liangzhi0754/three-fpga-musical-instrument/THIRD_PARTY_NOTICES.md

# 第三方许可说明

## Seeed Studio / PAJ7620 gesture library

`reference/Gesture.cpp` 和 `reference/vendor_paj7620.h` 保留了 Seeed Studio 的 MIT 许可头和版权声明。使用、复制或分发这些文件时应保留原许可和版权文字。

来源：<https://github.com/Seeed-Studio/Gesture_PAJ7620>

## Pololu / ST VL53L0X material

`reference/LICENSE-VL53L0X.txt` 保存了历史测距初始化代码涉及的 Pololu MIT 条款和 STMicroelectronics BSD-3-Clause 条款。当前作品已把测距模块从实际演奏交互中移出，但源码中仍保留历史初始化路径，因此继续保留告知文件。

## Board documentation

Tang Nano 20K 原理图和官方资料属于板卡厂商资料，本仓库只保留链接和自编接线说明，不把厂商 PDF 当作本项目原创内容重新授权。
