liangzhi0754/three-fpga-musical-instrument/program/README.md

# 烧录文件

稳定烧录文件不放在源码目录中，而放在 GitHub **Releases** 的附件中：

- `A_waveform_v25.fs` → A 板
- `B_CELLO_FLUTE_V21.fs` → B 板
- `C_CELLO_FLUTE_OLED_V21.fs` → C 板

三份文件不可互换。Release 同时提供 `Full_Source_Code_v1.0.0.rar` 和 `SHA256SUMS.txt`。
