liangzhi0754/three-fpga-musical-instrument/docs/architecture_1.png

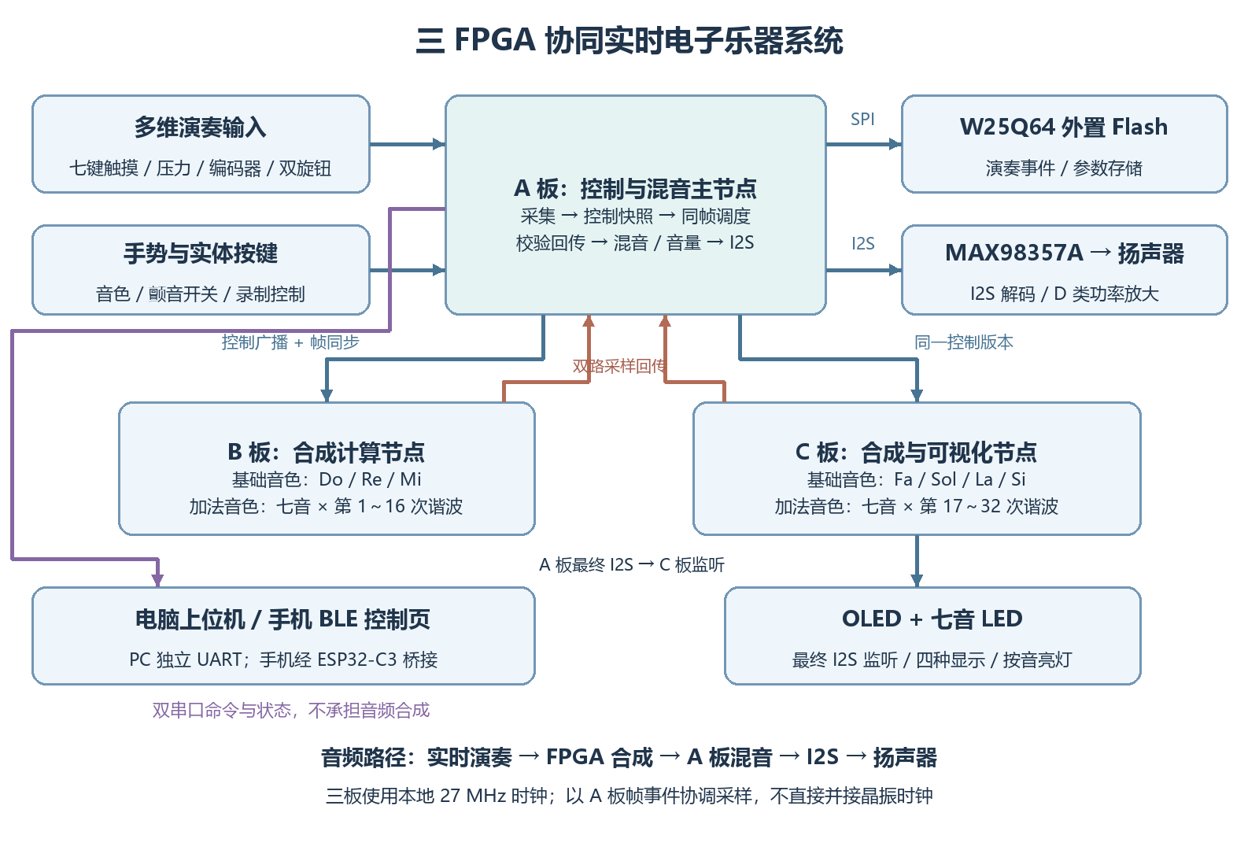
docs/architecture_1.png
