liangzhi0754/three-fpga-musical-instrument/docs/architecture_2.png

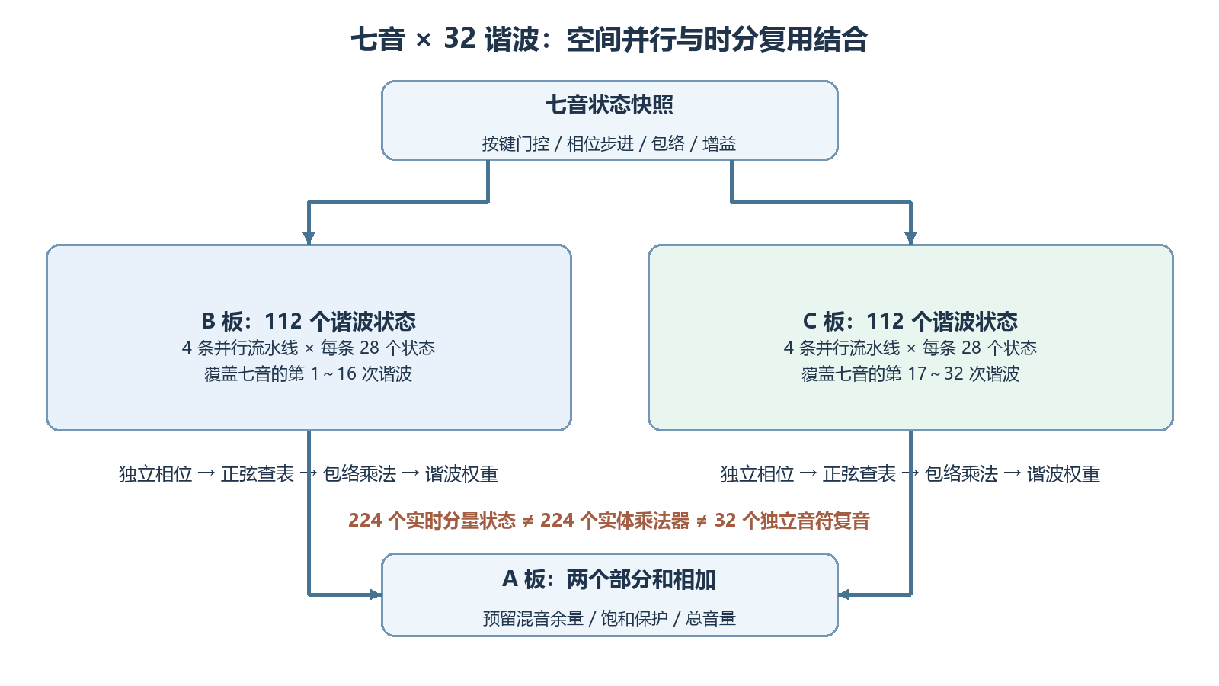
docs/architecture_2.png
