liangzhi0754/three-fpga-musical-instrument/docs/architecture_3.png

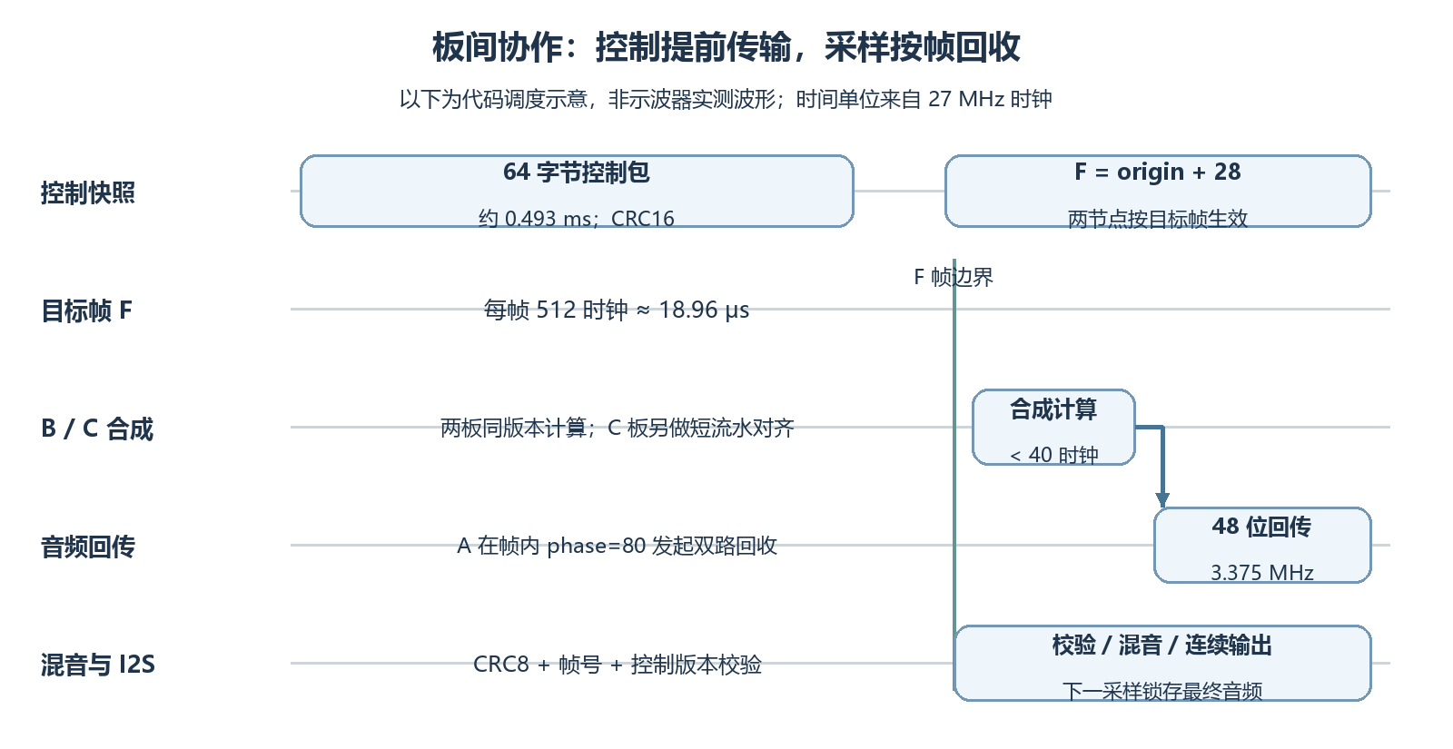
docs/architecture_3.png
