liangzhi0754/three-fpga-musical-instrument/docs/architecture_4.png

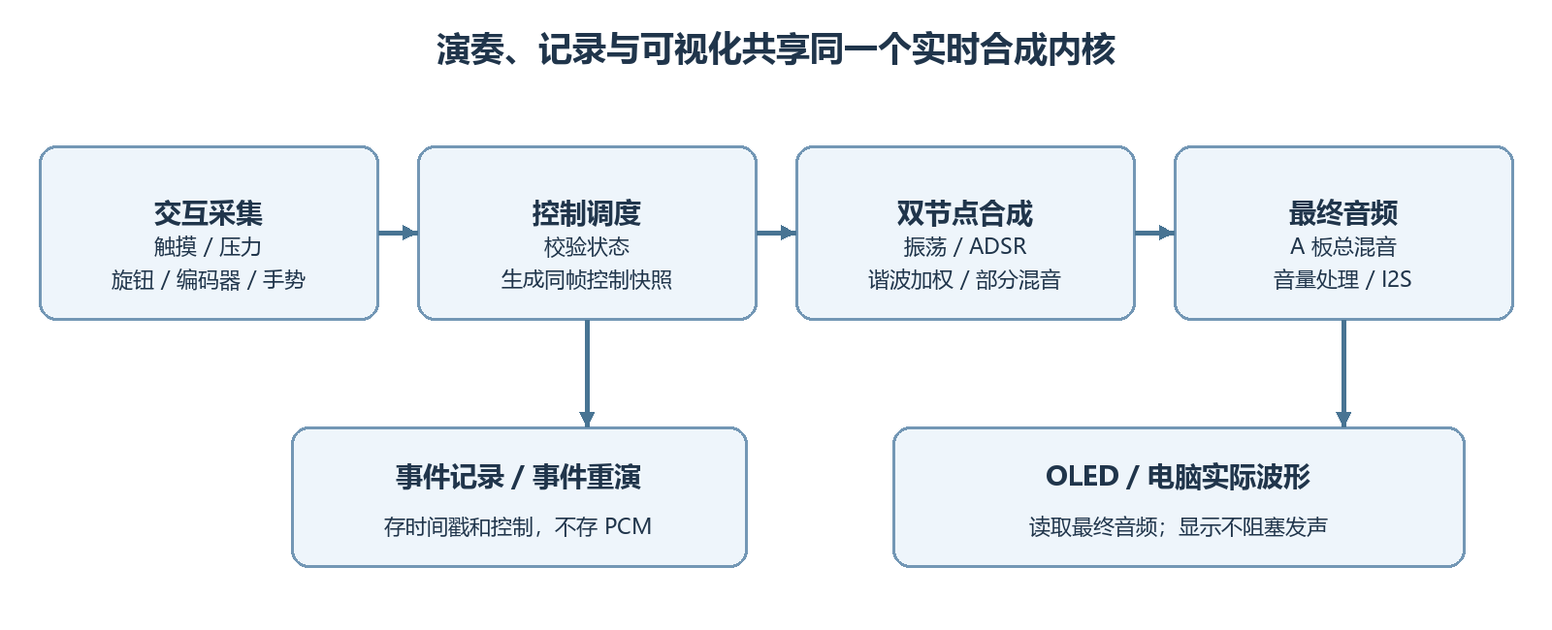
docs/architecture_4.png
