liangzhi0754/three-fpga-musical-instrument/A_WIRING.md

# A板全部接线表（v19）

表中 Axx、Bxx、Cxx 指各板丝印/引脚图对应的 FPGA 管脚编号，不是排针从上往下数的位置。以本工程 projects/A/pins.cst 为软件依据。

## 供电

- 各板与所有模块 GND 必须共地。
- 三块板的 3.3V 稳压输出不能互相并接；A侧传感器从 A板3.3V供电。
- 外接 MAX98357A 使用 LM2596 稳压5V；12V适配器只接LM2596输入。
- 不把外部5V直接并到正在USB供电的开发板5V引脚，除非已经确认电源隔离方式。

## A板信号逐脚核对

| A板管脚 | 信号/用途 | 连接对象 |
|---|---|---|
| A4 | 27MHz板载时钟 | 板内连接，不外接 |
| A15 | 板载状态LED | 板内连接，不外接 |
| A16 | 演奏帧同步输出 | 同时接 B25、C25 |
| A17 | 音频回传时钟输出 | 同时接 B73、C73 |
| A18 | REC录制键，低有效 | 常开按键另一端接公共GND |
| A19 | PLAY重演键，低有效 | 常开按键另一端接公共GND |
| A20 | 音频回传片选输出 | 同时接 B29、C29 |
| A25 | encoder_a编码器输入 | 保持已调通的编码器一相接法，见下文 |
| A27 | ADS总线SCL | 三片ADS1115的SCL并接此处 |
| A28 | ADS总线SDA | 三片ADS1115的SDA并接此处 |
| A29 | 外置Flash时钟 | W25Q64模块 CLK/SCK/SLK |
| A30 | 外置Flash数据输出MOSI | W25Q64模块 DI，芯片DIN/IO0 |
| A31 | 外置Flash片选 | W25Q64模块 CS |
| A41 | C板音频数据输入 | C30 |
| A42 | B板音频数据输入 | B30 |
| A48 | 外置Flash数据输入MISO | W25Q64模块 DO，芯片DOUT/IO1 |
| A49 | 板间控制片选 | 同时接 B26、C26 |
| A51 | 板载音频功放使能 | 软件固定关闭板载功放，不外接 |
| A52 | 电脑串口TX，A→电脑 | USB-TTL RXD |
| A53 | 音色切换键，低有效 | 常开按键另一端接公共GND |
| A54 | 手势总线SCL | PAJ7620U2 SCL |
| A55 | 手势总线SDA | PAJ7620U2 SDA |
| A56 | encoder_b编码器输入 | 保持已调通的编码器另一相接法，见下文 |
| A71 | 触摸总线SCL | MPR121 SCL |
| A72 | 触摸总线SDA | MPR121 SDA |
| A73 | I2S位时钟输出 | MAX98357A BCLK，同时接 C48 |
| A74 | I2S左右时钟输出 | MAX98357A LRC/LRCLK，同时接 C31 |
| A75 | I2S音频数据输出 | MAX98357A DIN，同时接 C41 |
| A76 | 手机/蓝牙串口TX | 暂不使用蓝牙时悬空；使用时接ESP32 GPIO5 |
| A77 | 板间控制时钟 | 同时接 B27、C27 |
| A79 | STOP停止键，低有效 | 常开按键另一端接公共GND |
| A80 | 手机/蓝牙串口RX | 暂不使用蓝牙时悬空；使用时接ESP32 GPIO4 |
| A85 | 板间控制数据 | 同时接 B28、C28 |
| A86 | 电脑串口RX，电脑→A | USB-TTL TXD |

## MPR121和七个铜箔

| 模块脚 | 接哪里 |
|---|---|
| VCC/VIN | 模块确认支持的3.3V供电输入，来自A侧3.3V |
| GND | 公共GND |
| SCL | A71 |
| SDA | A72 |
| ADDR | 公共GND，地址0x5A |
| IRQ | 当前轮询程序不用，悬空 |
| E11、E10、E8、E6、E4、E2、E0 | 分别接Do、Re、Mi、Fa、Sol、La、Si铜箔 |

## 三片ADS1115与电位器/压力片

三片VDD均接A侧3.3V，GND接公共GND，SCL接A27，SDA接A28；ALERT/RDY当前不用。

| ADS用途 | ADDR接法 | 地址 | 模拟输入 |
|---|---|---|---|
| 音高、音量 | GND | 0x48 | A0接音高电位器中间脚；A1接音量电位器中间脚 |
| 压力升降 | VDD（3.3V） | 0x49 | A0接升音压力分压点；A1接降音压力分压点；A2/A3预留 |
| 旧七路压力扩展预留 | SDA（与A28为同一网络） | 0x4A | A0/A1/A2预留；当前两片升降压力不依赖此片 |

每只电位器两侧脚接3.3V和GND，中间滑动脚才接ADS模拟输入。模拟输入不能接5V。

裸FSR两脚没有正负：`3.3V → FSR → 分压点 → 10kΩ电阻 → GND`；分压点接压力ADS的A0或A1。两片FSR各用一只电阻；未使用的模拟输入可接GND避免浮动读数。若现有压力方向已经调通，保持原分压方向。

## PAJ7620U2手势模块

VCC/VIN接模块确认允许的3.3V供电输入，GND接公共GND，SCL接A54，SDA接A55；INT当前不用。测距模块已停用，不需要连接。

## 旋转编码器

当前工程约束始终为encoder_a=A25、encoder_b=A56。你此前说实物按“26和56”已调通：保留那根已成功的实体线，先不要按旧文字重新移动。板上位置与软件编号的差异仍需按实物引脚图确认，不能把软件A25直接改口称A26。A26不是本工程编码器输入。

VCC接3.3V，GND接公共GND，A/B两相接上述两根已成功的信号线；C引脚的含义需按模块原理图确认，不能仅凭字母C当作地或按键。现有固件不用C输入。

## W25Q64特别注意

VCC接3.3V，GND接公共GND。模块若标注D0/D1，需确认其中0是数字还是字母O：**芯片DIN/IO0接A30，DOUT/IO1接A48**。DI/DO命名与IO0/IO1编号容易混淆，不根据“D0”猜方向。裸芯片的WP/HOLD必须被正确拉高；六脚模块一般已处理，按模块原理图核对。

## USB-TTL、功放与按键

- USB-TTL使用3.3V逻辑：RXD接A52，TXD接A86，GND共地，VCC不接。电脑双向控制不使用A76/A80。
- MAX98357A VIN接外部稳压5V，GND共地，BCLK/LRC/DIN按上表；SD_MODE/GAIN保持已经正常发声的接法。
- 扬声器只接功放SPK+和SPK-，这两根都不接公共GND。
- 常开按键按下应使相应信号脚接GND；四脚按键先用通断档识别两组，使用按下才导通的两脚。
- REC短按后松开开始录制；长按约1秒准备录制区。STOP短按停止，长按约1秒保存参数。
- OLED和七个外接LED在C板，不能接到A板同编号脚。
