liangzhi0754/three-fpga-musical-instrument/validation/INHERITED_V22_VALIDATION.md

# v22验证记录

本次仅A板手势过滤HDL变化。A板完整编译通过：Logic12945/20736、CLS8701/10368、BSRAM5/46、DSP4.5/24；27MHz时序Setup/Hold违例0，Fmax45.954MHz。A板最新报告在validation/release_reports/A。

本次 `_v22` 日志：11项HDL回归（新增手势过滤测试、PAJ I2C持续结果及换向、A板上下左右及关闭开关）、35项电脑端、三板音频/I2S/OLED端到端。B/C烧录文件及界面与v21逐字节一致，未对它们重新编译。未实物验证灵敏度或端到端延迟。

以下为继承的v21音色验证记录，表格A行仅代表v21；v22的A资源以上段为准。

编译工具：Gowin V1.9.11.03 Education；器件GW2AR-LV18QN88C8/I7；27MHz。

| 板 | Logic | CLS | BSRAM | DSP | Fmax |
|---|---:|---:|---:|---:|---:|
| A | 12771/20736 | 8710/10368 | 5/46 | 4.5/24 | 52.253MHz |
| B | 6247/20736 | 4424/10368 | 6/46 | 19/24 | 37.568MHz |
| C | 11102/20736 | 7213/10368 | 13/46 | 24/24 | 38.891MHz |

三板完整布局布线通过，Setup/Hold违例均为0。C的DSP用满，竹笛没有新增DSP；气息部分用移位加减与伪随机序列实现。A源码及所有引脚约束与v20一致，A亦重新编译并提供程序。最终报告在validation/release_reports。

本版验证：

- 大提琴与竹笛七音分别渲染后相加，与七键同按对照通过，最大整数舍入差8。每音独立相位/包络，释放音高保留；双板计算40时钟内完成。
- 真实HDL渲染Do/Mi/Sol，幅度范围和音色区别检查通过。频谱检查使用不重叠中心bin，并加入删掉任一正弦成分的负例，作为粗略音频检查；七音叠加对照是多音完整性的主要依据。
- 大提琴和弦输出逐样本与v20相同；前三音色与旧参考逐周期一致。
- 三板控制、CRC回传、音量混音、I2S、OLED端到端测试通过，包含ID4三音和弦。
- OLED、七键LED、压力、编码器、手势、两路串口、第五音色及五态循环回归通过。
- 存储真实SPI模型和慢擦除/STOP/故障恢复模型通过，覆盖音色4的录制重演。
- 电脑端35项测试通过，包含第五音色、和弦显示和存储状态。
- 手机端测试与使用限制见mobile/README.md，JS日志存于mobile/tests。

本次日志名称含 `_v21`；旧版日志不代表本次测试。资源报告为内部编译结果，原有通用时钟路由提示保留。没有测量实物端到端延迟，没有烧录硬件或进行BLE实机测试。

七音复音×每音32谐波，不能直接等同“32个独立音符复音”。竹笛为合成近似，没有真实录音采样或混响新增。旧音色4录音在v21会成为竹笛。手机页面需要手动更新至原网站并刷新，iPhone需支持Web Bluetooth的浏览器；未制作已签名原生iOS安装包，未重编译ESP32固件。
