liangzhi0754/three-fpga-musical-instrument/validation/board_a_tr_cata.html

- Timing Messages
- Timing Summaries
  - STA Tool Run Summary
  - Clock Summary
  - Max Frequency Summary
  - Total Negative Slack Summary
- Timing Details
  - Path Slacks Table
    - Setup Paths Table
    - Hold Paths Table
    - Recovery Paths Table
    - Removal Paths Table
  - Minimum Pulse Width Table
  - Timing Report By Analysis Type
    - Setup Analysis Report
    - Hold Analysis Report
    - Recovery Analysis Report
    - Removal Analysis Report
  - Minimum Pulse Width Report
  - High Fanout Nets Report
  - Route Congestions Report
  - Timing Exceptions Report
    - Setup Analysis Report
    - Hold Analysis Report
    - Recovery Analysis Report
    - Removal Analysis Report
  - Timing Constraints Report
