liangzhi0754/three-fpga-musical-instrument/validation/board_a_tr_content.html

# Timing Messages

Report Title | Timing Analysis Report
Design File | E:\qiansai\three_20k_waveform_v25\projects\A\impl\gwsynthesis\board_a.vg
Physical Constraints File | E:\qiansai\three_20k_waveform_v25\projects\A\pins.cst
Timing Constraint File | E:\qiansai\three_20k_waveform_v25\projects\A\timing.sdc
Tool Version | V1.9.11.03 Education
Part Number | GW2AR-LV18QN88C8/I7
Device | GW2AR-18
Device Version | C
Created Time | Sat Oct 31 16:38:56 2026
Legal Announcement | Copyright (C)2014-2025 Gowin Semiconductor Corporation. All rights reserved.

# Timing Summaries

## STA Tool Run Summary:

Setup Delay Model | Slow 0.95V 85C C8/I7
Hold Delay Model | Fast 1.05V 0C C8/I7
Numbers of Paths Analyzed | 21641
Numbers of Endpoints Analyzed | 20872
Numbers of Falling Endpoints | 0
Numbers of Setup Violated Endpoints | 0
Numbers of Hold Violated Endpoints | 0

## Clock Summary:

NO. | Clock Name | Type | Period | Frequency(MHz) | Rise | Fall | Source | Master | Objects
1 | sys_clk | Base | 37.037 | 27.000 | 0.000 | 18.518 | | | clk

## Max Frequency Summary:

NO. | Clock Name | Constraint | Actual Fmax | Logic Level | Entity
1 | sys_clk | 27.000(MHz) | 44.758(MHz) | 27 | TOP

## Total Negative Slack Summary:

Clock Name | Analysis Type | Endpoints TNS | Number of Endpoints
sys_clk | Setup | 0.000 | 0
sys_clk | Hold | 0.000 | 0

# Timing Details

## Path Slacks Table:

### Setup Paths Table

#### Report Command:report_timing -setup -max_paths 25 -max_common_paths 1

Path Number | Path Slack | From Node | To Node | From Clock | To Clock | Relation | Clock Skew | Data Delay
1 | 14.695 | control/event_packet_244_s0/Q | store/write_shift_489_s3/D | sys_clk:[R] | sys_clk:[R] | 37.037 | 0.000 | 22.307
2 | 14.873 | control/event_packet_244_s0/Q | store/enqueue_busy_s0/D | sys_clk:[R] | sys_clk:[R] | 37.037 | 0.000 | 22.129
3 | 14.972 | control/event_packet_244_s0/Q | store/write_shift_427_s3/D | sys_clk:[R] | sys_clk:[R] | 37.037 | 0.000 | 22.030
4 | 14.972 | control/event_packet_244_s0/Q | store/write_shift_491_s3/D | sys_clk:[R] | sys_clk:[R] | 37.037 | 0.000 | 22.030
5 | 15.192 | control/event_packet_244_s0/Q | store/write_shift_490_s3/D | sys_clk:[R] | sys_clk:[R] | 37.037 | 0.000 | 21.810
6 | 15.435 | control/event_packet_244_s0/Q | store/write_shift_420_s3/D | sys_clk:[R] | sys_clk:[R] | 37.037 | 0.000 | 21.567
7 | 15.435 | control/event_packet_244_s0/Q | store/write_shift_439_s3/D | sys_clk:[R] | sys_clk:[R] | 37.037 | 0.000 | 21.567
8 | 15.435 | control/event_packet_244_s0/Q | store/write_shift_503_s3/D | sys_clk:[R] | sys_clk:[R] | 37.037 | 0.000 | 21.567
9 | 15.718 | control/event_packet_244_s0/Q | store/write_shift_421_s3/D | sys_clk:[R] | sys_clk:[R] | 37.037 | 0.000 | 21.284
10 | 15.911 | control/event_packet_244_s0/Q | store/write_shift_393_s1/CE | sys_clk:[R] | sys_clk:[R] | 37.037 | 0.000 | 21.091
11 | 15.911 | control/event_packet_244_s0/Q | store/write_shift_425_s1/CE | sys_clk:[R] | sys_clk:[R] | 37.037 | 0.000 | 21.091
12 | 15.911 | control/event_packet_244_s0/Q | store/write_shift_457_s1/CE | sys_clk:[R] | sys_clk:[R] | 37.037 | 0.000 | 21.091
13 | 15.911 | control/event_packet_244_s0/Q | store/write_shift_521_s1/CE | sys_clk:[R] | sys_clk:[R] | 37.037 | 0.000 | 21.091
14 | 15.911 | control/event_packet_244_s0/Q | store/write_shift_522_s1/CE | sys_clk:[R] | sys_clk:[R] | 37.037 | 0.000 | 21.091
15 | 15.928 | control/event_packet_244_s0/Q | store/write_shift_501_s3/D | sys_clk:[R] | sys_clk:[R] | 37.037 | 0.000 | 21.074
16 | 15.928 | control/event_packet_244_s0/Q | store/write_shift_505_s3/D | sys_clk:[R] | sys_clk:[R] | 37.037 | 0.000 | 21.074
17 | 15.934 | control/event_packet_244_s0/Q | store/write_shift_444_s3/D | sys_clk:[R] | sys_clk:[R] | 37.037 | 0.000 | 21.068
18 | 15.934 | control/event_packet_244_s0/Q | store/write_shift_508_s3/D | sys_clk:[R] | sys_clk:[R] | 37.037 | 0.000 | 21.068
19 | 16.013 | control/event_packet_244_s0/Q | store/write_shift_494_s3/D | sys_clk:[R] | sys_clk:[R] | 37.037 | 0.000 | 20.989
20 | 16.022 | control/event_packet_244_s0/Q | store/write_shift_492_s3/D | sys_clk:[R] | sys_clk:[R] | 37.037 | 0.000 | 20.980
21 | 16.095 | control/event_packet_244_s0/Q | store/write_shift_297_s1/CE | sys_clk:[R] | sys_clk:[R] | 37.037 | 0.000 | 20.907
22 | 16.095 | control/event_packet_244_s0/Q | store/write_shift_329_s1/CE | sys_clk:[R] | sys_clk:[R] | 37.037 | 0.000 | 20.907
23 | 16.095 | control/event_packet_244_s0/Q | store/write_shift_361_s1/CE | sys_clk:[R] | sys_clk:[R] | 37.037 | 0.000 | 20.907
24 | 16.095 | control/event_packet_244_s0/Q | store/write_shift_394_s1/CE | sys_clk:[R] | sys_clk:[R] | 37.037 | 0.000 | 20.907
25 | 16.095 | control/event_packet_244_s0/Q | store/write_shift_426_s1/CE | sys_clk:[R] | sys_clk:[R] | 37.037 | 0.000 | 20.907

### Hold Paths Table

#### Report Command:report_timing -hold -max_paths 25 -max_common_paths 1

Path Number | Path Slack | From Node | To Node | From Clock | To Clock | Relation | Clock Skew | Data Delay
1 | 0.198 | store/write_shift_527_s1/Q | store/fifo_words_fifo_words_0_1_s/DI[7] | sys_clk:[R] | sys_clk:[R] | 0.000 | 0.000 | 0.447
2 | 0.211 | status/pc_transmitter/point_7_s6/Q | status/pc_transmitter/samples_samples_0_0_s/ADA[11] | sys_clk:[R] | sys_clk:[R] | 0.000 | 0.000 | 0.329
3 | 0.213 | store/write_shift_524_s1/Q | store/fifo_words_fifo_words_0_1_s/DI[4] | sys_clk:[R] | sys_clk:[R] | 0.000 | 0.000 | 0.462
4 | 0.213 | store/write_shift_523_s1/Q | store/fifo_words_fifo_words_0_1_s/DI[3] | sys_clk:[R] | sys_clk:[R] | 0.000 | 0.000 | 0.462
5 | 0.213 | store/write_shift_512_s1/Q | store/fifo_words_fifo_words_0_0_s/DI[0] | sys_clk:[R] | sys_clk:[R] | 0.000 | 0.000 | 0.462
6 | 0.225 | store/write_shift_539_s1/Q | store/fifo_words_fifo_words_0_3_s/DI[3] | sys_clk:[R] | sys_clk:[R] | 0.000 | 0.000 | 0.474
7 | 0.225 | store/write_shift_525_s1/Q | store/fifo_words_fifo_words_0_1_s/DI[5] | sys_clk:[R] | sys_clk:[R] | 0.000 | 0.000 | 0.474
8 | 0.225 | store/write_shift_514_s1/Q | store/fifo_words_fifo_words_0_0_s/DI[2] | sys_clk:[R] | sys_clk:[R] | 0.000 | 0.000 | 0.474
9 | 0.307 | store/device/jedec_id_8_s0/Q | store/device/jedec_id_16_s0/D | sys_clk:[R] | sys_clk:[R] | 0.000 | 0.000 | 0.318
10 | 0.307 | store/device/jedec_id_9_s0/Q | store/device/jedec_id_17_s0/D | sys_clk:[R] | sys_clk:[R] | 0.000 | 0.000 | 0.318
11 | 0.307 | store/device/jedec_id_10_s0/Q | store/device/jedec_id_18_s0/D | sys_clk:[R] | sys_clk:[R] | 0.000 | 0.000 | 0.318
12 | 0.307 | store/device/jedec_id_12_s0/Q | store/device/jedec_id_20_s0/D | sys_clk:[R] | sys_clk:[R] | 0.000 | 0.000 | 0.318
13 | 0.307 | store/device/jedec_id_14_s0/Q | store/device/jedec_id_22_s0/D | sys_clk:[R] | sys_clk:[R] | 0.000 | 0.000 | 0.318
14 | 0.307 | store/page_settings_230_s0/Q | store/page_settings_238_s0/D | sys_clk:[R] | sys_clk:[R] | 0.000 | 0.000 | 0.318
15 | 0.310 | link/b_40_s1/Q | link/sample_b_17_s0/D | sys_clk:[R] | sys_clk:[R] | 0.000 | 0.000 | 0.321
16 | 0.310 | link/b_41_s1/Q | link/sample_b_18_s0/D | sys_clk:[R] | sys_clk:[R] | 0.000 | 0.000 | 0.321
17 | 0.310 | control/origin_7_s0/Q | control/event_packet_455_s0/D | sys_clk:[R] | sys_clk:[R] | 0.000 | 0.000 | 0.321
18 | 0.310 | store/device/byte_engine/received_1_s0/Q | store/device/jedec_id_1_s0/D | sys_clk:[R] | sys_clk:[R] | 0.000 | 0.000 | 0.321
19 | 0.310 | store/device/byte_engine/received_2_s0/Q | store/device/jedec_id_2_s0/D | sys_clk:[R] | sys_clk:[R] | 0.000 | 0.000 | 0.321
20 | 0.310 | store/page_settings_6_s0/Q | store/page_settings_14_s0/D | sys_clk:[R] | sys_clk:[R] | 0.000 | 0.000 | 0.321
21 | 0.310 | store/page_settings_70_s0/Q | store/page_settings_78_s0/D | sys_clk:[R] | sys_clk:[R] | 0.000 | 0.000 | 0.321
22 | 0.310 | store/page_settings_118_s0/Q | store/page_settings_126_s0/D | sys_clk:[R] | sys_clk:[R] | 0.000 | 0.000 | 0.321
23 | 0.310 | store/page_settings_166_s0/Q | store/page_settings_174_s0/D | sys_clk:[R] | sys_clk:[R] | 0.000 | 0.000 | 0.321
24 | 0.310 | store/page_settings_214_s0/Q | store/page_settings_222_s0/D | sys_clk:[R] | sys_clk:[R] | 0.000 | 0.000 | 0.321
25 | 0.310 | store/page_sequence_19_s0/Q | store/page_sequence_27_s0/D | sys_clk:[R] | sys_clk:[R] | 0.000 | 0.000 | 0.321

### Recovery Paths Table

#### Report Command:report_timing -recovery -max_paths 25 -max_common_paths 1

#### Nothing to report!

### Removal Paths Table

#### Report Command:report_timing -removal -max_paths 25 -max_common_paths 1

#### Nothing to report!

## Minimum Pulse Width Table:

Number | Slack | Actual Width | Required Width | Type | Clock | Objects

#### Report Command:report_min_pulse_width -nworst 10 -detail

1 | 15.320 | 16.320 | 1.000 | Low Pulse Width | sys_clk | phase_7_s0
2 | 15.320 | 16.320 | 1.000 | Low Pulse Width | sys_clk | phase_5_s0
3 | 15.320 | 16.320 | 1.000 | Low Pulse Width | sys_clk | phase_1_s0
4 | 15.320 | 16.320 | 1.000 | Low Pulse Width | sys_clk | frame_9_s0
5 | 15.320 | 16.320 | 1.000 | Low Pulse Width | sys_clk | sample_time_25_s0
6 | 15.320 | 16.320 | 1.000 | Low Pulse Width | sys_clk | total_frames_29_s0
7 | 15.320 | 16.320 | 1.000 | Low Pulse Width | sys_clk | bad_c_28_s0
8 | 15.320 | 16.320 | 1.000 | Low Pulse Width | sys_clk | seq_c_24_s0
9 | 15.320 | 16.320 | 1.000 | Low Pulse Width | sys_clk | touch/bus/bit_index_2_s1
10 | 15.320 | 16.320 | 1.000 | Low Pulse Width | sys_clk | aux/slots[5]_1_s0

## Timing Report By Analysis Type:

### Setup Analysis Report

#### Report Command:report_timing -setup -max_paths 25 -max_common_paths 1

### Path1

Path Summary:

Slack | 14.695
Data Arrival Time | 27.636
Data Required Time | 42.331
From | control/event_packet_244_s0
To | store/write_shift_489_s3
Launch Clk | sys_clk:[R]
Latch Clk | sys_clk:[R]

Data Arrival Path:

AT | DELAY | TYPE | RF | FANOUT | LOC | NODE
0.000 | 0.000 | | | | | active clock edge time
0.000 | 0.000 | | | | | sys_clk
0.000 | 0.000 | tCL | RR | 1 | IOL7[A] | clk_ibuf/I
2.088 | 2.088 | tINS | RR | 9846 | IOL7[A] | clk_ibuf/O
5.329 | 3.241 | tNET | RR | 1 | R17C8[0][A] | control/event_packet_244_s0/CLK
5.561 | 0.232 | tC2Q | RF | 4 | R17C8[0][A] | control/event_packet_244_s0/Q
8.287 | 2.726 | tNET | FF | 1 | R54C5[3][A] | store/capture_packet_244_s0/I0
8.836 | 0.549 | tINS | FR | 1 | R54C5[3][A] | store/capture_packet_244_s0/F
8.980 | 0.144 | tNET | RR | 2 | R54C5[2][B] | store/n580_s0/I0
9.529 | 0.549 | tINS | RR | 1 | R54C5[2][B] | store/n580_s0/COUT
9.529 | 0.000 | tNET | RR | 2 | R54C6[0][A] | store/n581_s0/CIN
9.564 | 0.035 | tINS | RF | 1 | R54C6[0][A] | store/n581_s0/COUT
9.564 | 0.000 | tNET | FF | 2 | R54C6[0][B] | store/n582_s0/CIN
9.600 | 0.035 | tINS | FF | 1 | R54C6[0][B] | store/n582_s0/COUT
9.600 | 0.000 | tNET | FF | 2 | R54C6[1][A] | store/n583_s0/CIN
9.635 | 0.035 | tINS | FF | 1 | R54C6[1][A] | store/n583_s0/COUT
9.635 | 0.000 | tNET | FF | 2 | R54C6[1][B] | store/n584_s0/CIN
9.670 | 0.035 | tINS | FF | 1 | R54C6[1][B] | store/n584_s0/COUT
9.670 | 0.000 | tNET | FF | 2 | R54C6[2][A] | store/n585_s0/CIN
9.705 | 0.035 | tINS | FF | 1 | R54C6[2][A] | store/n585_s0/COUT
9.705 | 0.000 | tNET | FF | 2 | R54C6[2][B] | store/n586_s0/CIN
9.740 | 0.035 | tINS | FF | 1 | R54C6[2][B] | store/n586_s0/COUT
9.740 | 0.000 | tNET | FF | 2 | R54C7[0][A] | store/n587_s0/CIN
9.776 | 0.035 | tINS | FF | 1 | R54C7[0][A] | store/n587_s0/COUT
9.776 | 0.000 | tNET | FF | 2 | R54C7[0][B] | store/n588_s0/CIN
9.811 | 0.035 | tINS | FF | 1 | R54C7[0][B] | store/n588_s0/COUT
9.811 | 0.000 | tNET | FF | 2 | R54C7[1][A] | store/n589_s0/CIN
9.846 | 0.035 | tINS | FF | 1 | R54C7[1][A] | store/n589_s0/COUT
9.846 | 0.000 | tNET | FF | 2 | R54C7[1][B] | store/n590_s0/CIN
9.881 | 0.035 | tINS | FF | 1 | R54C7[1][B] | store/n590_s0/COUT
9.881 | 0.000 | tNET | FF | 2 | R54C7[2][A] | store/n591_s0/CIN
9.916 | 0.035 | tINS | FF | 1 | R54C7[2][A] | store/n591_s0/COUT
9.916 | 0.000 | tNET | FF | 2 | R54C7[2][B] | store/n592_s0/CIN
9.952 | 0.035 | tINS | FF | 1 | R54C7[2][B] | store/n592_s0/COUT
9.952 | 0.000 | tNET | FF | 2 | R54C8[0][A] | store/n593_s0/CIN
9.987 | 0.035 | tINS | FF | 1 | R54C8[0][A] | store/n593_s0/COUT
9.987 | 0.000 | tNET | FF | 2 | R54C8[0][B] | store/n594_s0/CIN
10.022 | 0.035 | tINS | FF | 1 | R54C8[0][B] | store/n594_s0/COUT
10.022 | 0.000 | tNET | FF | 2 | R54C8[1][A] | store/n595_s0/CIN
10.057 | 0.035 | tINS | FF | 1 | R54C8[1][A] | store/n595_s0/COUT
10.057 | 0.000 | tNET | FF | 2 | R54C8[1][B] | store/n596_s0/CIN
10.092 | 0.035 | tINS | FF | 1 | R54C8[1][B] | store/n596_s0/COUT
10.092 | 0.000 | tNET | FF | 2 | R54C8[2][A] | store/n597_s0/CIN
10.128 | 0.035 | tINS | FF | 1 | R54C8[2][A] | store/n597_s0/COUT
10.128 | 0.000 | tNET | FF | 2 | R54C8[2][B] | store/n598_s0/CIN
10.163 | 0.035 | tINS | FF | 1 | R54C8[2][B] | store/n598_s0/COUT
10.163 | 0.000 | tNET | FF | 2 | R54C9[0][A] | store/n599_s0/CIN
10.198 | 0.035 | tINS | FF | 1 | R54C9[0][A] | store/n599_s0/COUT
10.198 | 0.000 | tNET | FF | 2 | R54C9[0][B] | store/n600_s0/CIN
10.233 | 0.035 | tINS | FF | 1 | R54C9[0][B] | store/n600_s0/COUT
10.233 | 0.000 | tNET | FF | 2 | R54C9[1][A] | store/n601_s0/CIN
10.268 | 0.035 | tINS | FF | 1 | R54C9[1][A] | store/n601_s0/COUT
10.268 | 0.000 | tNET | FF | 2 | R54C9[1][B] | store/n602_s0/CIN
10.304 | 0.035 | tINS | FF | 1 | R54C9[1][B] | store/n602_s0/COUT
10.304 | 0.000 | tNET | FF | 2 | R54C9[2][A] | store/n603_s0/CIN
10.339 | 0.035 | tINS | FF | 1 | R54C9[2][A] | store/n603_s0/COUT
10.339 | 0.000 | tNET | FF | 2 | R54C9[2][B] | store/n604_s0/CIN
10.374 | 0.035 | tINS | FF | 1 | R54C9[2][B] | store/n604_s0/COUT
10.374 | 0.000 | tNET | FF | 2 | R54C10[0][A] | store/n605_s0/CIN
10.409 | 0.035 | tINS | FF | 1 | R54C10[0][A] | store/n605_s0/COUT
10.409 | 0.000 | tNET | FF | 2 | R54C10[0][B] | store/n606_s0/CIN
10.444 | 0.035 | tINS | FF | 1 | R54C10[0][B] | store/n606_s0/COUT
10.444 | 0.000 | tNET | FF | 2 | R54C10[1][A] | store/n607_s0/CIN
10.480 | 0.035 | tINS | FF | 1 | R54C10[1][A] | store/n607_s0/COUT
10.480 | 0.000 | tNET | FF | 2 | R54C10[1][B] | store/n608_s0/CIN
10.515 | 0.035 | tINS | FF | 1 | R54C10[1][B] | store/n608_s0/COUT
10.515 | 0.000 | tNET | FF | 2 | R54C10[2][A] | store/n609_s0/CIN
10.550 | 0.035 | tINS | FF | 1 | R54C10[2][A] | store/n609_s0/COUT
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
15.654 | 0.035 | tINS | FF | 1 | R54C34[2][B] | store/n762_s0/COUT
15.654 | 0.000 | tNET | FF | 2 | R54C35[0][A] | store/n768_s0/CIN
15.689 | 0.035 | tINS | FF | 1 | R54C35[0][A] | store/n768_s0/COUT
15.689 | 0.000 | tNET | FF | 2 | R54C35[0][B] | store/n769_s0/CIN
15.724 | 0.035 | tINS | FF | 1 | R54C35[0][B] | store/n769_s0/COUT
15.724 | 0.000 | tNET | FF | 2 | R54C35[1][A] | store/n770_s0/CIN
15.760 | 0.035 | tINS | FF | 1 | R54C35[1][A] | store/n770_s0/COUT
15.760 | 0.000 | tNET | FF | 2 | R54C35[1][B] | store/n771_s0/CIN
15.795 | 0.035 | tINS | FF | 1 | R54C35[1][B] | store/n771_s0/COUT
15.795 | 0.000 | tNET | FF | 2 | R54C35[2][A] | store/n772_s0/CIN
15.830 | 0.035 | tINS | FF | 1 | R54C35[2][A] | store/n772_s0/COUT
15.830 | 0.000 | tNET | FF | 2 | R54C35[2][B] | store/n773_s0/CIN
15.865 | 0.035 | tINS | FF | 1 | R54C35[2][B] | store/n773_s0/COUT
15.865 | 0.000 | tNET | FF | 2 | R54C36[0][A] | store/n774_s0/CIN
15.900 | 0.035 | tINS | FF | 2 | R54C36[0][A] | store/n774_s0/COUT
18.220 | 2.319 | tNET | FF | 1 | R36C14[0][B] | store/last_record_time_31_s6/I1
18.682 | 0.462 | tINS | FR | 1 | R36C14[0][B] | store/last_record_time_31_s6/F
18.854 | 0.172 | tNET | RR | 1 | R36C13[3][B] | store/last_record_time_31_s4/I3
19.409 | 0.555 | tINS | RF | 11 | R36C13[3][B] | store/last_record_time_31_s4/F
19.834 | 0.425 | tNET | FF | 1 | R34C12[3][B] | store/last_record_time_31_s2/I2
20.205 | 0.371 | tINS | FF | 222 | R34C12[3][B] | store/last_record_time_31_s2/F
23.596 | 3.391 | tNET | FF | 1 | R34C5[3][A] | store/write_shift_543_s4/I1
24.049 | 0.453 | tINS | FF | 313 | R34C5[3][A] | store/write_shift_543_s4/F
27.087 | 3.039 | tNET | FF | 1 | R47C14[0][B] | store/n21525_s6/I0
27.636 | 0.549 | tINS | FR | 1 | R47C14[0][B] | store/n21525_s6/F
27.636 | 0.000 | tNET | RR | 1 | R47C14[0][B] | store/write_shift_489_s3/D

Data Required Path:

AT | DELAY | TYPE | RF | FANOUT | LOC | NODE
37.037 | 37.037 | | | | | active clock edge time
37.037 | 0.000 | | | | | sys_clk
37.037 | 0.000 | tCL | RR | 1 | IOL7[A] | clk_ibuf/I
39.125 | 2.088 | tINS | RR | 9846 | IOL7[A] | clk_ibuf/O
42.366 | 3.241 | tNET | RR | 1 | R47C14[0][B] | store/write_shift_489_s3/CLK
42.331 | -0.035 | tSu | | 1 | R47C14[0][B] | store/write_shift_489_s3

Path Statistics:

Clock Skew | 0.000
Setup Relationship | 37.037
Logic Level | 27
Arrival Clock Path Delay | cell: 2.088, 39.180%; route: 3.241, 60.820%
Arrival Data Path Delay | cell: 9.859, 44.198%; route: 12.216, 54.762%; tC2Q: 0.232, 1.040%
Required Clock Path Delay | cell: 2.088, 39.180%; route: 3.241, 60.820%

### Path2

Path Summary:

Slack | 14.873
Data Arrival Time | 27.458
Data Required Time | 42.331
From | control/event_packet_244_s0
To | store/enqueue_busy_s0
Launch Clk | sys_clk:[R]
Latch Clk | sys_clk:[R]

Data Arrival Path:

AT | DELAY | TYPE | RF | FANOUT | LOC | NODE
0.000 | 0.000 | | | | | active clock edge time
0.000 | 0.000 | | | | | sys_clk
0.000 | 0.000 | tCL | RR | 1 | IOL7[A] | clk_ibuf/I
2.088 | 2.088 | tINS | RR | 9846 | IOL7[A] | clk_ibuf/O
5.329 | 3.241 | tNET | RR | 1 | R17C8[0][A] | control/event_packet_244_s0/CLK
5.561 | 0.232 | tC2Q | RF | 4 | R17C8[0][A] | control/event_packet_244_s0/Q
8.287 | 2.726 | tNET | FF | 1 | R54C5[3][A] | store/capture_packet_244_s0/I0
8.836 | 0.549 | tINS | FR | 1 | R54C5[3][A] | store/capture_packet_244_s0/F
8.980 | 0.144 | tNET | RR | 2 | R54C5[2][B] | store/n580_s0/I0
9.529 | 0.549 | tINS | RR | 1 | R54C5[2][B] | store/n580_s0/COUT
9.529 | 0.000 | tNET | RR | 2 | R54C6[0][A] | store/n581_s0/CIN
9.564 | 0.035 | tINS | RF | 1 | R54C6[0][A] | store/n581_s0/COUT
9.564 | 0.000 | tNET | FF | 2 | R54C6[0][B] | store/n582_s0/CIN
9.600 | 0.035 | tINS | FF | 1 | R54C6[0][B] | store/n582_s0/COUT
9.600 | 0.000 | tNET | FF | 2 | R54C6[1][A] | store/n583_s0/CIN
9.635 | 0.035 | tINS | FF | 1 | R54C6[1][A] | store/n583_s0/COUT
9.635 | 0.000 | tNET | FF | 2 | R54C6[1][B] | store/n584_s0/CIN
9.670 | 0.035 | tINS | FF | 1 | R54C6[1][B] | store/n584_s0/COUT
9.670 | 0.000 | tNET | FF | 2 | R54C6[2][A] | store/n585_s0/CIN
9.705 | 0.035 | tINS | FF | 1 | R54C6[2][A] | store/n585_s0/COUT
9.705 | 0.000 | tNET | FF | 2 | R54C6[2][B] | store/n586_s0/CIN
9.740 | 0.035 | tINS | FF | 1 | R54C6[2][B] | store/n586_s0/COUT
9.740 | 0.000 | tNET | FF | 2 | R54C7[0][A] | store/n587_s0/CIN
9.776 | 0.035 | tINS | FF | 1 | R54C7[0][A] | store/n587_s0/COUT
9.776 | 0.000 | tNET | FF | 2 | R54C7[0][B] | store/n588_s0/CIN
9.811 | 0.035 | tINS | FF | 1 | R54C7[0][B] | store/n588_s0/COUT
9.811 | 0.000 | tNET | FF | 2 | R54C7[1][A] | store/n589_s0/CIN
9.846 | 0.035 | tINS | FF | 1 | R54C7[1][A] | store/n589_s0/COUT
9.846 | 0.000 | tNET | FF | 2 | R54C7[1][B] | store/n590_s0/CIN
9.881 | 0.035 | tINS | FF | 1 | R54C7[1][B] | store/n590_s0/COUT
9.881 | 0.000 | tNET | FF | 2 | R54C7[2][A] | store/n591_s0/CIN
9.916 | 0.035 | tINS | FF | 1 | R54C7[2][A] | store/n591_s0/COUT
9.916 | 0.000 | tNET | FF | 2 | R54C7[2][B] | store/n592_s0/CIN
9.952 | 0.035 | tINS | FF | 1 | R54C7[2][B] | store/n592_s0/COUT
9.952 | 0.000 | tNET | FF | 2 | R54C8[0][A] | store/n593_s0/CIN
9.987 | 0.035 | tINS | FF | 1 | R54C8[0][A] | store/n593_s0/COUT
9.987 | 0.000 | tNET | FF | 2 | R54C8[0][B] | store/n594_s0/CIN
10.022 | 0.035 | tINS | FF | 1 | R54C8[0][B] | store/n594_s0/COUT
10.022 | 0.000 | tNET | FF | 2 | R54C8[1][A] | store/n595_s0/CIN
10.057 | 0.035 | tINS | FF | 1 | R54C8[1][A] | store/n595_s0/COUT
10.057 | 0.000 | tNET | FF | 2 | R54C8[1][B] | store/n596_s0/CIN
10.092 | 0.035 | tINS | FF | 1 | R54C8[1][B] | store/n596_s0/COUT
10.092 | 0.000 | tNET | FF | 2 | R54C8[2][A] | store/n597_s0/CIN
10.128 | 0.035 | tINS | FF | 1 | R54C8[2][A] | store/n597_s0/COUT
10.128 | 0.000 | tNET | FF | 2 | R54C8[2][B] | store/n598_s0/CIN
10.163 | 0.035 | tINS | FF | 1 | R54C8[2][B] | store/n598_s0/COUT
10.163 | 0.000 | tNET | FF | 2 | R54C9[0][A] | store/n599_s0/CIN
10.198 | 0.035 | tINS | FF | 1 | R54C9[0][A] | store/n599_s0/COUT
10.198 | 0.000 | tNET | FF | 2 | R54C9[0][B] | store/n600_s0/CIN
10.233 | 0.035 | tINS | FF | 1 | R54C9[0][B] | store/n600_s0/COUT
10.233 | 0.000 | tNET | FF | 2 | R54C9[1][A] | store/n601_s0/CIN
10.268 | 0.035 | tINS | FF | 1 | R54C9[1][A] | store/n601_s0/COUT
10.268 | 0.000 | tNET | FF | 2 | R54C9[1][B] | store/n602_s0/CIN
10.304 | 0.035 | tINS | FF | 1 | R54C9[1][B] | store/n602_s0/COUT
10.304 | 0.000 | tNET | FF | 2 | R54C9[2][A] | store/n603_s0/CIN
10.339 | 0.035 | tINS | FF | 1 | R54C9[2][A] | store/n603_s0/COUT
10.339 | 0.000 | tNET | FF | 2 | R54C9[2][B] | store/n604_s0/CIN
10.374 | 0.035 | tINS | FF | 1 | R54C9[2][B] | store/n604_s0/COUT
10.374 | 0.000 | tNET | FF | 2 | R54C10[0][A] | store/n605_s0/CIN
10.409 | 0.035 | tINS | FF | 1 | R54C10[0][A] | store/n605_s0/COUT
10.409 | 0.000 | tNET | FF | 2 | R54C10[0][B] | store/n606_s0/CIN
10.444 | 0.035 | tINS | FF | 1 | R54C10[0][B] | store/n606_s0/COUT
10.444 | 0.000 | tNET | FF | 2 | R54C10[1][A] | store/n607_s0/CIN
10.480 | 0.035 | tINS | FF | 1 | R54C10[1][A] | store/n607_s0/COUT
10.480 | 0.000 | tNET | FF | 2 | R54C10[1][B] | store/n608_s0/CIN
10.515 | 0.035 | tINS | FF | 1 | R54C10[1][B] | store/n608_s0/COUT
10.515 | 0.000 | tNET | FF | 2 | R54C10[2][A] | store/n609_s0/CIN
10.550 | 0.035 | tINS | FF | 1 | R54C10[2][A] | store/n609_s0/COUT
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
15.654 | 0.035 | tINS | FF | 1 | R54C34[2][B] | store/n762_s0/COUT
15.654 | 0.000 | tNET | FF | 2 | R54C35[0][A] | store/n768_s0/CIN
15.689 | 0.035 | tINS | FF | 1 | R54C35[0][A] | store/n768_s0/COUT
15.689 | 0.000 | tNET | FF | 2 | R54C35[0][B] | store/n769_s0/CIN
15.724 | 0.035 | tINS | FF | 1 | R54C35[0][B] | store/n769_s0/COUT
15.724 | 0.000 | tNET | FF | 2 | R54C35[1][A] | store/n770_s0/CIN
15.760 | 0.035 | tINS | FF | 1 | R54C35[1][A] | store/n770_s0/COUT
15.760 | 0.000 | tNET | FF | 2 | R54C35[1][B] | store/n771_s0/CIN
15.795 | 0.035 | tINS | FF | 1 | R54C35[1][B] | store/n771_s0/COUT
15.795 | 0.000 | tNET | FF | 2 | R54C35[2][A] | store/n772_s0/CIN
15.830 | 0.035 | tINS | FF | 1 | R54C35[2][A] | store/n772_s0/COUT
15.830 | 0.000 | tNET | FF | 2 | R54C35[2][B] | store/n773_s0/CIN
15.865 | 0.035 | tINS | FF | 1 | R54C35[2][B] | store/n773_s0/COUT
15.865 | 0.000 | tNET | FF | 2 | R54C36[0][A] | store/n774_s0/CIN
15.900 | 0.035 | tINS | FF | 2 | R54C36[0][A] | store/n774_s0/COUT
18.220 | 2.319 | tNET | FF | 1 | R36C14[0][B] | store/last_record_time_31_s6/I1
18.682 | 0.462 | tINS | FR | 1 | R36C14[0][B] | store/last_record_time_31_s6/F
18.854 | 0.172 | tNET | RR | 1 | R36C13[3][B] | store/last_record_time_31_s4/I3
19.409 | 0.555 | tINS | RF | 11 | R36C13[3][B] | store/last_record_time_31_s4/F
19.834 | 0.425 | tNET | FF | 1 | R34C12[3][B] | store/last_record_time_31_s2/I2
20.205 | 0.371 | tINS | FF | 222 | R34C12[3][B] | store/last_record_time_31_s2/F
23.596 | 3.391 | tNET | FF | 1 | R34C5[3][A] | store/write_shift_543_s4/I1
24.049 | 0.453 | tINS | FF | 313 | R34C5[3][A] | store/write_shift_543_s4/F
27.087 | 3.039 | tNET | FF | 1 | R49C15[0][B] | store/n21336_s5/I3
27.458 | 0.371 | tINS | FF | 1 | R49C15[0][B] | store/n21336_s5/F
27.458 | 0.000 | tNET | FF | 1 | R49C15[0][B] | store/enqueue_busy_s0/D

Data Required Path:

AT | DELAY | TYPE | RF | FANOUT | LOC | NODE
37.037 | 37.037 | | | | | active clock edge time
37.037 | 0.000 | | | | | sys_clk
37.037 | 0.000 | tCL | RR | 1 | IOL7[A] | clk_ibuf/I
39.125 | 2.088 | tINS | RR | 9846 | IOL7[A] | clk_ibuf/O
42.366 | 3.241 | tNET | RR | 1 | R49C15[0][B] | store/enqueue_busy_s0/CLK
42.331 | -0.035 | tSu | | 1 | R49C15[0][B] | store/enqueue_busy_s0

Path Statistics:

Clock Skew | 0.000
Setup Relationship | 37.037
Logic Level | 27
Arrival Clock Path Delay | cell: 2.088, 39.180%; route: 3.241, 60.820%
Arrival Data Path Delay | cell: 9.681, 43.749%; route: 12.216, 55.203%; tC2Q: 0.232, 1.048%
Required Clock Path Delay | cell: 2.088, 39.180%; route: 3.241, 60.820%

### Path3

Path Summary:

Slack | 14.972
Data Arrival Time | 27.359
Data Required Time | 42.331
From | control/event_packet_244_s0
To | store/write_shift_427_s3
Launch Clk | sys_clk:[R]
Latch Clk | sys_clk:[R]

Data Arrival Path:

AT | DELAY | TYPE | RF | FANOUT | LOC | NODE
0.000 | 0.000 | | | | | active clock edge time
0.000 | 0.000 | | | | | sys_clk
0.000 | 0.000 | tCL | RR | 1 | IOL7[A] | clk_ibuf/I
2.088 | 2.088 | tINS | RR | 9846 | IOL7[A] | clk_ibuf/O
5.329 | 3.241 | tNET | RR | 1 | R17C8[0][A] | control/event_packet_244_s0/CLK
5.561 | 0.232 | tC2Q | RF | 4 | R17C8[0][A] | control/event_packet_244_s0/Q
8.287 | 2.726 | tNET | FF | 1 | R54C5[3][A] | store/capture_packet_244_s0/I0
8.836 | 0.549 | tINS | FR | 1 | R54C5[3][A] | store/capture_packet_244_s0/F
8.980 | 0.144 | tNET | RR | 2 | R54C5[2][B] | store/n580_s0/I0
9.529 | 0.549 | tINS | RR | 1 | R54C5[2][B] | store/n580_s0/COUT
9.529 | 0.000 | tNET | RR | 2 | R54C6[0][A] | store/n581_s0/CIN
9.564 | 0.035 | tINS | RF | 1 | R54C6[0][A] | store/n581_s0/COUT
9.564 | 0.000 | tNET | FF | 2 | R54C6[0][B] | store/n582_s0/CIN
9.600 | 0.035 | tINS | FF | 1 | R54C6[0][B] | store/n582_s0/COUT
9.600 | 0.000 | tNET | FF | 2 | R54C6[1][A] | store/n583_s0/CIN
9.635 | 0.035 | tINS | FF | 1 | R54C6[1][A] | store/n583_s0/COUT
9.635 | 0.000 | tNET | FF | 2 | R54C6[1][B] | store/n584_s0/CIN
9.670 | 0.035 | tINS | FF | 1 | R54C6[1][B] | store/n584_s0/COUT
9.670 | 0.000 | tNET | FF | 2 | R54C6[2][A] | store/n585_s0/CIN
9.705 | 0.035 | tINS | FF | 1 | R54C6[2][A] | store/n585_s0/COUT
9.705 | 0.000 | tNET | FF | 2 | R54C6[2][B] | store/n586_s0/CIN
9.740 | 0.035 | tINS | FF | 1 | R54C6[2][B] | store/n586_s0/COUT
9.740 | 0.000 | tNET | FF | 2 | R54C7[0][A] | store/n587_s0/CIN
9.776 | 0.035 | tINS | FF | 1 | R54C7[0][A] | store/n587_s0/COUT
9.776 | 0.000 | tNET | FF | 2 | R54C7[0][B] | store/n588_s0/CIN
9.811 | 0.035 | tINS | FF | 1 | R54C7[0][B] | store/n588_s0/COUT
9.811 | 0.000 | tNET | FF | 2 | R54C7[1][A] | store/n589_s0/CIN
9.846 | 0.035 | tINS | FF | 1 | R54C7[1][A] | store/n589_s0/COUT
9.846 | 0.000 | tNET | FF | 2 | R54C7[1][B] | store/n590_s0/CIN
9.881 | 0.035 | tINS | FF | 1 | R54C7[1][B] | store/n590_s0/COUT
9.881 | 0.000 | tNET | FF | 2 | R54C7[2][A] | store/n591_s0/CIN
9.916 | 0.035 | tINS | FF | 1 | R54C7[2][A] | store/n591_s0/COUT
9.916 | 0.000 | tNET | FF | 2 | R54C7[2][B] | store/n592_s0/CIN
9.952 | 0.035 | tINS | FF | 1 | R54C7[2][B] | store/n592_s0/COUT
9.952 | 0.000 | tNET | FF | 2 | R54C8[0][A] | store/n593_s0/CIN
9.987 | 0.035 | tINS | FF | 1 | R54C8[0][A] | store/n593_s0/COUT
9.987 | 0.000 | tNET | FF | 2 | R54C8[0][B] | store/n594_s0/CIN
10.022 | 0.035 | tINS | FF | 1 | R54C8[0][B] | store/n594_s0/COUT
10.022 | 0.000 | tNET | FF | 2 | R54C8[1][A] | store/n595_s0/CIN
10.057 | 0.035 | tINS | FF | 1 | R54C8[1][A] | store/n595_s0/COUT
10.057 | 0.000 | tNET | FF | 2 | R54C8[1][B] | store/n596_s0/CIN
10.092 | 0.035 | tINS | FF | 1 | R54C8[1][B] | store/n596_s0/COUT
10.092 | 0.000 | tNET | FF | 2 | R54C8[2][A] | store/n597_s0/CIN
10.128 | 0.035 | tINS | FF | 1 | R54C8[2][A] | store/n597_s0/COUT
10.128 | 0.000 | tNET | FF | 2 | R54C8[2][B] | store/n598_s0/CIN
10.163 | 0.035 | tINS | FF | 1 | R54C8[2][B] | store/n598_s0/COUT
10.163 | 0.000 | tNET | FF | 2 | R54C9[0][A] | store/n599_s0/CIN
10.198 | 0.035 | tINS | FF | 1 | R54C9[0][A] | store/n599_s0/COUT
10.198 | 0.000 | tNET | FF | 2 | R54C9[0][B] | store/n600_s0/CIN
10.233 | 0.035 | tINS | FF | 1 | R54C9[0][B] | store/n600_s0/COUT
10.233 | 0.000 | tNET | FF | 2 | R54C9[1][A] | store/n601_s0/CIN
10.268 | 0.035 | tINS | FF | 1 | R54C9[1][A] | store/n601_s0/COUT
10.268 | 0.000 | tNET | FF | 2 | R54C9[1][B] | store/n602_s0/CIN
10.304 | 0.035 | tINS | FF | 1 | R54C9[1][B] | store/n602_s0/COUT
10.304 | 0.000 | tNET | FF | 2 | R54C9[2][A] | store/n603_s0/CIN
10.339 | 0.035 | tINS | FF | 1 | R54C9[2][A] | store/n603_s0/COUT
10.339 | 0.000 | tNET | FF | 2 | R54C9[2][B] | store/n604_s0/CIN
10.374 | 0.035 | tINS | FF | 1 | R54C9[2][B] | store/n604_s0/COUT
10.374 | 0.000 | tNET | FF | 2 | R54C10[0][A] | store/n605_s0/CIN
10.409 | 0.035 | tINS | FF | 1 | R54C10[0][A] | store/n605_s0/COUT
10.409 | 0.000 | tNET | FF | 2 | R54C10[0][B] | store/n606_s0/CIN
10.444 | 0.035 | tINS | FF | 1 | R54C10[0][B] | store/n606_s0/COUT
10.444 | 0.000 | tNET | FF | 2 | R54C10[1][A] | store/n607_s0/CIN
10.480 | 0.035 | tINS | FF | 1 | R54C10[1][A] | store/n607_s0/COUT
10.480 | 0.000 | tNET | FF | 2 | R54C10[1][B] | store/n608_s0/CIN
10.515 | 0.035 | tINS | FF | 1 | R54C10[1][B] | store/n608_s0/COUT
10.515 | 0.000 | tNET | FF | 2 | R54C10[2][A] | store/n609_s0/CIN
10.550 | 0.035 | tINS | FF | 1 | R54C10[2][A] | store/n609_s0/COUT
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
15.654 | 0.035 | tINS | FF | 1 | R54C34[2][B] | store/n762_s0/COUT
15.654 | 0.000 | tNET | FF | 2 | R54C35[0][A] | store/n768_s0/CIN
15.689 | 0.035 | tINS | FF | 1 | R54C35[0][A] | store/n768_s0/COUT
15.689 | 0.000 | tNET | FF | 2 | R54C35[0][B] | store/n769_s0/CIN
15.724 | 0.035 | tINS | FF | 1 | R54C35[0][B] | store/n769_s0/COUT
15.724 | 0.000 | tNET | FF | 2 | R54C35[1][A] | store/n770_s0/CIN
15.760 | 0.035 | tINS | FF | 1 | R54C35[1][A] | store/n770_s0/COUT
15.760 | 0.000 | tNET | FF | 2 | R54C35[1][B] | store/n771_s0/CIN
15.795 | 0.035 | tINS | FF | 1 | R54C35[1][B] | store/n771_s0/COUT
15.795 | 0.000 | tNET | FF | 2 | R54C35[2][A] | store/n772_s0/CIN
15.830 | 0.035 | tINS | FF | 1 | R54C35[2][A] | store/n772_s0/COUT
15.830 | 0.000 | tNET | FF | 2 | R54C35[2][B] | store/n773_s0/CIN
15.865 | 0.035 | tINS | FF | 1 | R54C35[2][B] | store/n773_s0/COUT
15.865 | 0.000 | tNET | FF | 2 | R54C36[0][A] | store/n774_s0/CIN
15.900 | 0.035 | tINS | FF | 2 | R54C36[0][A] | store/n774_s0/COUT
18.220 | 2.319 | tNET | FF | 1 | R36C14[0][B] | store/last_record_time_31_s6/I1
18.682 | 0.462 | tINS | FR | 1 | R36C14[0][B] | store/last_record_time_31_s6/F
18.854 | 0.172 | tNET | RR | 1 | R36C13[3][B] | store/last_record_time_31_s4/I3
19.409 | 0.555 | tINS | RF | 11 | R36C13[3][B] | store/last_record_time_31_s4/F
19.834 | 0.425 | tNET | FF | 1 | R34C12[3][B] | store/last_record_time_31_s2/I2
20.205 | 0.371 | tINS | FF | 222 | R34C12[3][B] | store/last_record_time_31_s2/F
23.596 | 3.391 | tNET | FF | 1 | R34C5[3][A] | store/write_shift_543_s4/I1
24.049 | 0.453 | tINS | FF | 313 | R34C5[3][A] | store/write_shift_543_s4/F
26.810 | 2.762 | tNET | FF | 1 | R43C11[1][B] | store/n21587_s6/I0
27.359 | 0.549 | tINS | FR | 1 | R43C11[1][B] | store/n21587_s6/F
27.359 | 0.000 | tNET | RR | 1 | R43C11[1][B] | store/write_shift_427_s3/D

Data Required Path:

AT | DELAY | TYPE | RF | FANOUT | LOC | NODE
37.037 | 37.037 | | | | | active clock edge time
37.037 | 0.000 | | | | | sys_clk
37.037 | 0.000 | tCL | RR | 1 | IOL7[A] | clk_ibuf/I
39.125 | 2.088 | tINS | RR | 9846 | IOL7[A] | clk_ibuf/O
42.366 | 3.241 | tNET | RR | 1 | R43C11[1][B] | store/write_shift_427_s3/CLK
42.331 | -0.035 | tSu | | 1 | R43C11[1][B] | store/write_shift_427_s3

Path Statistics:

Clock Skew | 0.000
Setup Relationship | 37.037
Logic Level | 27
Arrival Clock Path Delay | cell: 2.088, 39.180%; route: 3.241, 60.820%
Arrival Data Path Delay | cell: 9.859, 44.754%; route: 11.939, 54.193%; tC2Q: 0.232, 1.053%
Required Clock Path Delay | cell: 2.088, 39.180%; route: 3.241, 60.820%

### Path4

Path Summary:

Slack | 14.972
Data Arrival Time | 27.359
Data Required Time | 42.331
From | control/event_packet_244_s0
To | store/write_shift_491_s3
Launch Clk | sys_clk:[R]
Latch Clk | sys_clk:[R]

Data Arrival Path:

AT | DELAY | TYPE | RF | FANOUT | LOC | NODE
0.000 | 0.000 | | | | | active clock edge time
0.000 | 0.000 | | | | | sys_clk
0.000 | 0.000 | tCL | RR | 1 | IOL7[A] | clk_ibuf/I
2.088 | 2.088 | tINS | RR | 9846 | IOL7[A] | clk_ibuf/O
5.329 | 3.241 | tNET | RR | 1 | R17C8[0][A] | control/event_packet_244_s0/CLK
5.561 | 0.232 | tC2Q | RF | 4 | R17C8[0][A] | control/event_packet_244_s0/Q
8.287 | 2.726 | tNET | FF | 1 | R54C5[3][A] | store/capture_packet_244_s0/I0
8.836 | 0.549 | tINS | FR | 1 | R54C5[3][A] | store/capture_packet_244_s0/F
8.980 | 0.144 | tNET | RR | 2 | R54C5[2][B] | store/n580_s0/I0
9.529 | 0.549 | tINS | RR | 1 | R54C5[2][B] | store/n580_s0/COUT
9.529 | 0.000 | tNET | RR | 2 | R54C6[0][A] | store/n581_s0/CIN
9.564 | 0.035 | tINS | RF | 1 | R54C6[0][A] | store/n581_s0/COUT
9.564 | 0.000 | tNET | FF | 2 | R54C6[0][B] | store/n582_s0/CIN
9.600 | 0.035 | tINS | FF | 1 | R54C6[0][B] | store/n582_s0/COUT
9.600 | 0.000 | tNET | FF | 2 | R54C6[1][A] | store/n583_s0/CIN
9.635 | 0.035 | tINS | FF | 1 | R54C6[1][A] | store/n583_s0/COUT
9.635 | 0.000 | tNET | FF | 2 | R54C6[1][B] | store/n584_s0/CIN
9.670 | 0.035 | tINS | FF | 1 | R54C6[1][B] | store/n584_s0/COUT
9.670 | 0.000 | tNET | FF | 2 | R54C6[2][A] | store/n585_s0/CIN
9.705 | 0.035 | tINS | FF | 1 | R54C6[2][A] | store/n585_s0/COUT
9.705 | 0.000 | tNET | FF | 2 | R54C6[2][B] | store/n586_s0/CIN
9.740 | 0.035 | tINS | FF | 1 | R54C6[2][B] | store/n586_s0/COUT
9.740 | 0.000 | tNET | FF | 2 | R54C7[0][A] | store/n587_s0/CIN
9.776 | 0.035 | tINS | FF | 1 | R54C7[0][A] | store/n587_s0/COUT
9.776 | 0.000 | tNET | FF | 2 | R54C7[0][B] | store/n588_s0/CIN
9.811 | 0.035 | tINS | FF | 1 | R54C7[0][B] | store/n588_s0/COUT
9.811 | 0.000 | tNET | FF | 2 | R54C7[1][A] | store/n589_s0/CIN
9.846 | 0.035 | tINS | FF | 1 | R54C7[1][A] | store/n589_s0/COUT
9.846 | 0.000 | tNET | FF | 2 | R54C7[1][B] | store/n590_s0/CIN
9.881 | 0.035 | tINS | FF | 1 | R54C7[1][B] | store/n590_s0/COUT
9.881 | 0.000 | tNET | FF | 2 | R54C7[2][A] | store/n591_s0/CIN
9.916 | 0.035 | tINS | FF | 1 | R54C7[2][A] | store/n591_s0/COUT
9.916 | 0.000 | tNET | FF | 2 | R54C7[2][B] | store/n592_s0/CIN
9.952 | 0.035 | tINS | FF | 1 | R54C7[2][B] | store/n592_s0/COUT
9.952 | 0.000 | tNET | FF | 2 | R54C8[0][A] | store/n593_s0/CIN
9.987 | 0.035 | tINS | FF | 1 | R54C8[0][A] | store/n593_s0/COUT
9.987 | 0.000 | tNET | FF | 2 | R54C8[0][B] | store/n594_s0/CIN
10.022 | 0.035 | tINS | FF | 1 | R54C8[0][B] | store/n594_s0/COUT
10.022 | 0.000 | tNET | FF | 2 | R54C8[1][A] | store/n595_s0/CIN
10.057 | 0.035 | tINS | FF | 1 | R54C8[1][A] | store/n595_s0/COUT
10.057 | 0.000 | tNET | FF | 2 | R54C8[1][B] | store/n596_s0/CIN
10.092 | 0.035 | tINS | FF | 1 | R54C8[1][B] | store/n596_s0/COUT
10.092 | 0.000 | tNET | FF | 2 | R54C8[2][A] | store/n597_s0/CIN
10.128 | 0.035 | tINS | FF | 1 | R54C8[2][A] | store/n597_s0/COUT
10.128 | 0.000 | tNET | FF | 2 | R54C8[2][B] | store/n598_s0/CIN
10.163 | 0.035 | tINS | FF | 1 | R54C8[2][B] | store/n598_s0/COUT
10.163 | 0.000 | tNET | FF | 2 | R54C9[0][A] | store/n599_s0/CIN
10.198 | 0.035 | tINS | FF | 1 | R54C9[0][A] | store/n599_s0/COUT
10.198 | 0.000 | tNET | FF | 2 | R54C9[0][B] | store/n600_s0/CIN
10.233 | 0.035 | tINS | FF | 1 | R54C9[0][B] | store/n600_s0/COUT
10.233 | 0.000 | tNET | FF | 2 | R54C9[1][A] | store/n601_s0/CIN
10.268 | 0.035 | tINS | FF | 1 | R54C9[1][A] | store/n601_s0/COUT
10.268 | 0.000 | tNET | FF | 2 | R54C9[1][B] | store/n602_s0/CIN
10.304 | 0.035 | tINS | FF | 1 | R54C9[1][B] | store/n602_s0/COUT
10.304 | 0.000 | tNET | FF | 2 | R54C9[2][A] | store/n603_s0/CIN
10.339 | 0.035 | tINS | FF | 1 | R54C9[2][A] | store/n603_s0/COUT
10.339 | 0.000 | tNET | FF | 2 | R54C9[2][B] | store/n604_s0/CIN
10.374 | 0.035 | tINS | FF | 1 | R54C9[2][B] | store/n604_s0/COUT
10.374 | 0.000 | tNET | FF | 2 | R54C10[0][A] | store/n605_s0/CIN
10.409 | 0.035 | tINS | FF | 1 | R54C10[0][A] | store/n605_s0/COUT
10.409 | 0.000 | tNET | FF | 2 | R54C10[0][B] | store/n606_s0/CIN
10.444 | 0.035 | tINS | FF | 1 | R54C10[0][B] | store/n606_s0/COUT
10.444 | 0.000 | tNET | FF | 2 | R54C10[1][A] | store/n607_s0/CIN
10.480 | 0.035 | tINS | FF | 1 | R54C10[1][A] | store/n607_s0/COUT
10.480 | 0.000 | tNET | FF | 2 | R54C10[1][B] | store/n608_s0/CIN
10.515 | 0.035 | tINS | FF | 1 | R54C10[1][B] | store/n608_s0/COUT
10.515 | 0.000 | tNET | FF | 2 | R54C10[2][A] | store/n609_s0/CIN
10.550 | 0.035 | tINS | FF | 1 | R54C10[2][A] | store/n609_s0/COUT
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
15.654 | 0.035 | tINS | FF | 1 | R54C34[2][B] | store/n762_s0/COUT
15.654 | 0.000 | tNET | FF | 2 | R54C35[0][A] | store/n768_s0/CIN
15.689 | 0.035 | tINS | FF | 1 | R54C35[0][A] | store/n768_s0/COUT
15.689 | 0.000 | tNET | FF | 2 | R54C35[0][B] | store/n769_s0/CIN
15.724 | 0.035 | tINS | FF | 1 | R54C35[0][B] | store/n769_s0/COUT
15.724 | 0.000 | tNET | FF | 2 | R54C35[1][A] | store/n770_s0/CIN
15.760 | 0.035 | tINS | FF | 1 | R54C35[1][A] | store/n770_s0/COUT
15.760 | 0.000 | tNET | FF | 2 | R54C35[1][B] | store/n771_s0/CIN
15.795 | 0.035 | tINS | FF | 1 | R54C35[1][B] | store/n771_s0/COUT
15.795 | 0.000 | tNET | FF | 2 | R54C35[2][A] | store/n772_s0/CIN
15.830 | 0.035 | tINS | FF | 1 | R54C35[2][A] | store/n772_s0/COUT
15.830 | 0.000 | tNET | FF | 2 | R54C35[2][B] | store/n773_s0/CIN
15.865 | 0.035 | tINS | FF | 1 | R54C35[2][B] | store/n773_s0/COUT
15.865 | 0.000 | tNET | FF | 2 | R54C36[0][A] | store/n774_s0/CIN
15.900 | 0.035 | tINS | FF | 2 | R54C36[0][A] | store/n774_s0/COUT
18.220 | 2.319 | tNET | FF | 1 | R36C14[0][B] | store/last_record_time_31_s6/I1
18.682 | 0.462 | tINS | FR | 1 | R36C14[0][B] | store/last_record_time_31_s6/F
18.854 | 0.172 | tNET | RR | 1 | R36C13[3][B] | store/last_record_time_31_s4/I3
19.409 | 0.555 | tINS | RF | 11 | R36C13[3][B] | store/last_record_time_31_s4/F
19.834 | 0.425 | tNET | FF | 1 | R34C12[3][B] | store/last_record_time_31_s2/I2
20.205 | 0.371 | tINS | FF | 222 | R34C12[3][B] | store/last_record_time_31_s2/F
23.596 | 3.391 | tNET | FF | 1 | R34C5[3][A] | store/write_shift_543_s4/I1
24.049 | 0.453 | tINS | FF | 313 | R34C5[3][A] | store/write_shift_543_s4/F
26.810 | 2.762 | tNET | FF | 1 | R43C11[1][A] | store/n21523_s6/I0
27.359 | 0.549 | tINS | FR | 1 | R43C11[1][A] | store/n21523_s6/F
27.359 | 0.000 | tNET | RR | 1 | R43C11[1][A] | store/write_shift_491_s3/D

Data Required Path:

AT | DELAY | TYPE | RF | FANOUT | LOC | NODE
37.037 | 37.037 | | | | | active clock edge time
37.037 | 0.000 | | | | | sys_clk
37.037 | 0.000 | tCL | RR | 1 | IOL7[A] | clk_ibuf/I
39.125 | 2.088 | tINS | RR | 9846 | IOL7[A] | clk_ibuf/O
42.366 | 3.241 | tNET | RR | 1 | R43C11[1][A] | store/write_shift_491_s3/CLK
42.331 | -0.035 | tSu | | 1 | R43C11[1][A] | store/write_shift_491_s3

Path Statistics:

Clock Skew | 0.000
Setup Relationship | 37.037
Logic Level | 27
Arrival Clock Path Delay | cell: 2.088, 39.180%; route: 3.241, 60.820%
Arrival Data Path Delay | cell: 9.859, 44.754%; route: 11.939, 54.193%; tC2Q: 0.232, 1.053%
Required Clock Path Delay | cell: 2.088, 39.180%; route: 3.241, 60.820%

### Path5

Path Summary:

Slack | 15.192
Data Arrival Time | 27.139
Data Required Time | 42.331
From | control/event_packet_244_s0
To | store/write_shift_490_s3
Launch Clk | sys_clk:[R]
Latch Clk | sys_clk:[R]

Data Arrival Path:

AT | DELAY | TYPE | RF | FANOUT | LOC | NODE
0.000 | 0.000 | | | | | active clock edge time
0.000 | 0.000 | | | | | sys_clk
0.000 | 0.000 | tCL | RR | 1 | IOL7[A] | clk_ibuf/I
2.088 | 2.088 | tINS | RR | 9846 | IOL7[A] | clk_ibuf/O
5.329 | 3.241 | tNET | RR | 1 | R17C8[0][A] | control/event_packet_244_s0/CLK
5.561 | 0.232 | tC2Q | RF | 4 | R17C8[0][A] | control/event_packet_244_s0/Q
8.287 | 2.726 | tNET | FF | 1 | R54C5[3][A] | store/capture_packet_244_s0/I0
8.836 | 0.549 | tINS | FR | 1 | R54C5[3][A] | store/capture_packet_244_s0/F
8.980 | 0.144 | tNET | RR | 2 | R54C5[2][B] | store/n580_s0/I0
9.529 | 0.549 | tINS | RR | 1 | R54C5[2][B] | store/n580_s0/COUT
9.529 | 0.000 | tNET | RR | 2 | R54C6[0][A] | store/n581_s0/CIN
9.564 | 0.035 | tINS | RF | 1 | R54C6[0][A] | store/n581_s0/COUT
9.564 | 0.000 | tNET | FF | 2 | R54C6[0][B] | store/n582_s0/CIN
9.600 | 0.035 | tINS | FF | 1 | R54C6[0][B] | store/n582_s0/COUT
9.600 | 0.000 | tNET | FF | 2 | R54C6[1][A] | store/n583_s0/CIN
9.635 | 0.035 | tINS | FF | 1 | R54C6[1][A] | store/n583_s0/COUT
9.635 | 0.000 | tNET | FF | 2 | R54C6[1][B] | store/n584_s0/CIN
9.670 | 0.035 | tINS | FF | 1 | R54C6[1][B] | store/n584_s0/COUT
9.670 | 0.000 | tNET | FF | 2 | R54C6[2][A] | store/n585_s0/CIN
9.705 | 0.035 | tINS | FF | 1 | R54C6[2][A] | store/n585_s0/COUT
9.705 | 0.000 | tNET | FF | 2 | R54C6[2][B] | store/n586_s0/CIN
9.740 | 0.035 | tINS | FF | 1 | R54C6[2][B] | store/n586_s0/COUT
9.740 | 0.000 | tNET | FF | 2 | R54C7[0][A] | store/n587_s0/CIN
9.776 | 0.035 | tINS | FF | 1 | R54C7[0][A] | store/n587_s0/COUT
9.776 | 0.000 | tNET | FF | 2 | R54C7[0][B] | store/n588_s0/CIN
9.811 | 0.035 | tINS | FF | 1 | R54C7[0][B] | store/n588_s0/COUT
9.811 | 0.000 | tNET | FF | 2 | R54C7[1][A] | store/n589_s0/CIN
9.846 | 0.035 | tINS | FF | 1 | R54C7[1][A] | store/n589_s0/COUT
9.846 | 0.000 | tNET | FF | 2 | R54C7[1][B] | store/n590_s0/CIN
9.881 | 0.035 | tINS | FF | 1 | R54C7[1][B] | store/n590_s0/COUT
9.881 | 0.000 | tNET | FF | 2 | R54C7[2][A] | store/n591_s0/CIN
9.916 | 0.035 | tINS | FF | 1 | R54C7[2][A] | store/n591_s0/COUT
9.916 | 0.000 | tNET | FF | 2 | R54C7[2][B] | store/n592_s0/CIN
9.952 | 0.035 | tINS | FF | 1 | R54C7[2][B] | store/n592_s0/COUT
9.952 | 0.000 | tNET | FF | 2 | R54C8[0][A] | store/n593_s0/CIN
9.987 | 0.035 | tINS | FF | 1 | R54C8[0][A] | store/n593_s0/COUT
9.987 | 0.000 | tNET | FF | 2 | R54C8[0][B] | store/n594_s0/CIN
10.022 | 0.035 | tINS | FF | 1 | R54C8[0][B] | store/n594_s0/COUT
10.022 | 0.000 | tNET | FF | 2 | R54C8[1][A] | store/n595_s0/CIN
10.057 | 0.035 | tINS | FF | 1 | R54C8[1][A] | store/n595_s0/COUT
10.057 | 0.000 | tNET | FF | 2 | R54C8[1][B] | store/n596_s0/CIN
10.092 | 0.035 | tINS | FF | 1 | R54C8[1][B] | store/n596_s0/COUT
10.092 | 0.000 | tNET | FF | 2 | R54C8[2][A] | store/n597_s0/CIN
10.128 | 0.035 | tINS | FF | 1 | R54C8[2][A] | store/n597_s0/COUT
10.128 | 0.000 | tNET | FF | 2 | R54C8[2][B] | store/n598_s0/CIN
10.163 | 0.035 | tINS | FF | 1 | R54C8[2][B] | store/n598_s0/COUT
10.163 | 0.000 | tNET | FF | 2 | R54C9[0][A] | store/n599_s0/CIN
10.198 | 0.035 | tINS | FF | 1 | R54C9[0][A] | store/n599_s0/COUT
10.198 | 0.000 | tNET | FF | 2 | R54C9[0][B] | store/n600_s0/CIN
10.233 | 0.035 | tINS | FF | 1 | R54C9[0][B] | store/n600_s0/COUT
10.233 | 0.000 | tNET | FF | 2 | R54C9[1][A] | store/n601_s0/CIN
10.268 | 0.035 | tINS | FF | 1 | R54C9[1][A] | store/n601_s0/COUT
10.268 | 0.000 | tNET | FF | 2 | R54C9[1][B] | store/n602_s0/CIN
10.304 | 0.035 | tINS | FF | 1 | R54C9[1][B] | store/n602_s0/COUT
10.304 | 0.000 | tNET | FF | 2 | R54C9[2][A] | store/n603_s0/CIN
10.339 | 0.035 | tINS | FF | 1 | R54C9[2][A] | store/n603_s0/COUT
10.339 | 0.000 | tNET | FF | 2 | R54C9[2][B] | store/n604_s0/CIN
10.374 | 0.035 | tINS | FF | 1 | R54C9[2][B] | store/n604_s0/COUT
10.374 | 0.000 | tNET | FF | 2 | R54C10[0][A] | store/n605_s0/CIN
10.409 | 0.035 | tINS | FF | 1 | R54C10[0][A] | store/n605_s0/COUT
10.409 | 0.000 | tNET | FF | 2 | R54C10[0][B] | store/n606_s0/CIN
10.444 | 0.035 | tINS | FF | 1 | R54C10[0][B] | store/n606_s0/COUT
10.444 | 0.000 | tNET | FF | 2 | R54C10[1][A] | store/n607_s0/CIN
10.480 | 0.035 | tINS | FF | 1 | R54C10[1][A] | store/n607_s0/COUT
10.480 | 0.000 | tNET | FF | 2 | R54C10[1][B] | store/n608_s0/CIN
10.515 | 0.035 | tINS | FF | 1 | R54C10[1][B] | store/n608_s0/COUT
10.515 | 0.000 | tNET | FF | 2 | R54C10[2][A] | store/n609_s0/CIN
10.550 | 0.035 | tINS | FF | 1 | R54C10[2][A] | store/n609_s0/COUT
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
15.654 | 0.035 | tINS | FF | 1 | R54C34[2][B] | store/n762_s0/COUT
15.654 | 0.000 | tNET | FF | 2 | R54C35[0][A] | store/n768_s0/CIN
15.689 | 0.035 | tINS | FF | 1 | R54C35[0][A] | store/n768_s0/COUT
15.689 | 0.000 | tNET | FF | 2 | R54C35[0][B] | store/n769_s0/CIN
15.724 | 0.035 | tINS | FF | 1 | R54C35[0][B] | store/n769_s0/COUT
15.724 | 0.000 | tNET | FF | 2 | R54C35[1][A] | store/n770_s0/CIN
15.760 | 0.035 | tINS | FF | 1 | R54C35[1][A] | store/n770_s0/COUT
15.760 | 0.000 | tNET | FF | 2 | R54C35[1][B] | store/n771_s0/CIN
15.795 | 0.035 | tINS | FF | 1 | R54C35[1][B] | store/n771_s0/COUT
15.795 | 0.000 | tNET | FF | 2 | R54C35[2][A] | store/n772_s0/CIN
15.830 | 0.035 | tINS | FF | 1 | R54C35[2][A] | store/n772_s0/COUT
15.830 | 0.000 | tNET | FF | 2 | R54C35[2][B] | store/n773_s0/CIN
15.865 | 0.035 | tINS | FF | 1 | R54C35[2][B] | store/n773_s0/COUT
15.865 | 0.000 | tNET | FF | 2 | R54C36[0][A] | store/n774_s0/CIN
15.900 | 0.035 | tINS | FF | 2 | R54C36[0][A] | store/n774_s0/COUT
18.220 | 2.319 | tNET | FF | 1 | R36C14[0][B] | store/last_record_time_31_s6/I1
18.682 | 0.462 | tINS | FR | 1 | R36C14[0][B] | store/last_record_time_31_s6/F
18.854 | 0.172 | tNET | RR | 1 | R36C13[3][B] | store/last_record_time_31_s4/I3
19.409 | 0.555 | tINS | RF | 11 | R36C13[3][B] | store/last_record_time_31_s4/F
19.834 | 0.425 | tNET | FF | 1 | R34C12[3][B] | store/last_record_time_31_s2/I2
20.205 | 0.371 | tINS | FF | 222 | R34C12[3][B] | store/last_record_time_31_s2/F
23.596 | 3.391 | tNET | FF | 1 | R34C5[3][A] | store/write_shift_543_s4/I1
24.049 | 0.453 | tINS | FF | 313 | R34C5[3][A] | store/write_shift_543_s4/F
26.590 | 2.542 | tNET | FF | 1 | R49C11[0][A] | store/n21524_s6/I0
27.139 | 0.549 | tINS | FR | 1 | R49C11[0][A] | store/n21524_s6/F
27.139 | 0.000 | tNET | RR | 1 | R49C11[0][A] | store/write_shift_490_s3/D

Data Required Path:

AT | DELAY | TYPE | RF | FANOUT | LOC | NODE
37.037 | 37.037 | | | | | active clock edge time
37.037 | 0.000 | | | | | sys_clk
37.037 | 0.000 | tCL | RR | 1 | IOL7[A] | clk_ibuf/I
39.125 | 2.088 | tINS | RR | 9846 | IOL7[A] | clk_ibuf/O
42.366 | 3.241 | tNET | RR | 1 | R49C11[0][A] | store/write_shift_490_s3/CLK
42.331 | -0.035 | tSu | | 1 | R49C11[0][A] | store/write_shift_490_s3

Path Statistics:

Clock Skew | 0.000
Setup Relationship | 37.037
Logic Level | 27
Arrival Clock Path Delay | cell: 2.088, 39.180%; route: 3.241, 60.820%
Arrival Data Path Delay | cell: 9.859, 45.205%; route: 11.719, 53.731%; tC2Q: 0.232, 1.064%
Required Clock Path Delay | cell: 2.088, 39.180%; route: 3.241, 60.820%

### Path6

Path Summary:

Slack | 15.435
Data Arrival Time | 26.897
Data Required Time | 42.331
From | control/event_packet_244_s0
To | store/write_shift_420_s3
Launch Clk | sys_clk:[R]
Latch Clk | sys_clk:[R]

Data Arrival Path:

AT | DELAY | TYPE | RF | FANOUT | LOC | NODE
0.000 | 0.000 | | | | | active clock edge time
0.000 | 0.000 | | | | | sys_clk
0.000 | 0.000 | tCL | RR | 1 | IOL7[A] | clk_ibuf/I
2.088 | 2.088 | tINS | RR | 9846 | IOL7[A] | clk_ibuf/O
5.329 | 3.241 | tNET | RR | 1 | R17C8[0][A] | control/event_packet_244_s0/CLK
5.561 | 0.232 | tC2Q | RF | 4 | R17C8[0][A] | control/event_packet_244_s0/Q
8.287 | 2.726 | tNET | FF | 1 | R54C5[3][A] | store/capture_packet_244_s0/I0
8.836 | 0.549 | tINS | FR | 1 | R54C5[3][A] | store/capture_packet_244_s0/F
8.980 | 0.144 | tNET | RR | 2 | R54C5[2][B] | store/n580_s0/I0
9.529 | 0.549 | tINS | RR | 1 | R54C5[2][B] | store/n580_s0/COUT
9.529 | 0.000 | tNET | RR | 2 | R54C6[0][A] | store/n581_s0/CIN
9.564 | 0.035 | tINS | RF | 1 | R54C6[0][A] | store/n581_s0/COUT
9.564 | 0.000 | tNET | FF | 2 | R54C6[0][B] | store/n582_s0/CIN
9.600 | 0.035 | tINS | FF | 1 | R54C6[0][B] | store/n582_s0/COUT
9.600 | 0.000 | tNET | FF | 2 | R54C6[1][A] | store/n583_s0/CIN
9.635 | 0.035 | tINS | FF | 1 | R54C6[1][A] | store/n583_s0/COUT
9.635 | 0.000 | tNET | FF | 2 | R54C6[1][B] | store/n584_s0/CIN
9.670 | 0.035 | tINS | FF | 1 | R54C6[1][B] | store/n584_s0/COUT
9.670 | 0.000 | tNET | FF | 2 | R54C6[2][A] | store/n585_s0/CIN
9.705 | 0.035 | tINS | FF | 1 | R54C6[2][A] | store/n585_s0/COUT
9.705 | 0.000 | tNET | FF | 2 | R54C6[2][B] | store/n586_s0/CIN
9.740 | 0.035 | tINS | FF | 1 | R54C6[2][B] | store/n586_s0/COUT
9.740 | 0.000 | tNET | FF | 2 | R54C7[0][A] | store/n587_s0/CIN
9.776 | 0.035 | tINS | FF | 1 | R54C7[0][A] | store/n587_s0/COUT
9.776 | 0.000 | tNET | FF | 2 | R54C7[0][B] | store/n588_s0/CIN
9.811 | 0.035 | tINS | FF | 1 | R54C7[0][B] | store/n588_s0/COUT
9.811 | 0.000 | tNET | FF | 2 | R54C7[1][A] | store/n589_s0/CIN
9.846 | 0.035 | tINS | FF | 1 | R54C7[1][A] | store/n589_s0/COUT
9.846 | 0.000 | tNET | FF | 2 | R54C7[1][B] | store/n590_s0/CIN
9.881 | 0.035 | tINS | FF | 1 | R54C7[1][B] | store/n590_s0/COUT
9.881 | 0.000 | tNET | FF | 2 | R54C7[2][A] | store/n591_s0/CIN
9.916 | 0.035 | tINS | FF | 1 | R54C7[2][A] | store/n591_s0/COUT
9.916 | 0.000 | tNET | FF | 2 | R54C7[2][B] | store/n592_s0/CIN
9.952 | 0.035 | tINS | FF | 1 | R54C7[2][B] | store/n592_s0/COUT
9.952 | 0.000 | tNET | FF | 2 | R54C8[0][A] | store/n593_s0/CIN
9.987 | 0.035 | tINS | FF | 1 | R54C8[0][A] | store/n593_s0/COUT
9.987 | 0.000 | tNET | FF | 2 | R54C8[0][B] | store/n594_s0/CIN
10.022 | 0.035 | tINS | FF | 1 | R54C8[0][B] | store/n594_s0/COUT
10.022 | 0.000 | tNET | FF | 2 | R54C8[1][A] | store/n595_s0/CIN
10.057 | 0.035 | tINS | FF | 1 | R54C8[1][A] | store/n595_s0/COUT
10.057 | 0.000 | tNET | FF | 2 | R54C8[1][B] | store/n596_s0/CIN
10.092 | 0.035 | tINS | FF | 1 | R54C8[1][B] | store/n596_s0/COUT
10.092 | 0.000 | tNET | FF | 2 | R54C8[2][A] | store/n597_s0/CIN
10.128 | 0.035 | tINS | FF | 1 | R54C8[2][A] | store/n597_s0/COUT
10.128 | 0.000 | tNET | FF | 2 | R54C8[2][B] | store/n598_s0/CIN
10.163 | 0.035 | tINS | FF | 1 | R54C8[2][B] | store/n598_s0/COUT
10.163 | 0.000 | tNET | FF | 2 | R54C9[0][A] | store/n599_s0/CIN
10.198 | 0.035 | tINS | FF | 1 | R54C9[0][A] | store/n599_s0/COUT
10.198 | 0.000 | tNET | FF | 2 | R54C9[0][B] | store/n600_s0/CIN
10.233 | 0.035 | tINS | FF | 1 | R54C9[0][B] | store/n600_s0/COUT
10.233 | 0.000 | tNET | FF | 2 | R54C9[1][A] | store/n601_s0/CIN
10.268 | 0.035 | tINS | FF | 1 | R54C9[1][A] | store/n601_s0/COUT
10.268 | 0.000 | tNET | FF | 2 | R54C9[1][B] | store/n602_s0/CIN
10.304 | 0.035 | tINS | FF | 1 | R54C9[1][B] | store/n602_s0/COUT
10.304 | 0.000 | tNET | FF | 2 | R54C9[2][A] | store/n603_s0/CIN
10.339 | 0.035 | tINS | FF | 1 | R54C9[2][A] | store/n603_s0/COUT
10.339 | 0.000 | tNET | FF | 2 | R54C9[2][B] | store/n604_s0/CIN
10.374 | 0.035 | tINS | FF | 1 | R54C9[2][B] | store/n604_s0/COUT
10.374 | 0.000 | tNET | FF | 2 | R54C10[0][A] | store/n605_s0/CIN
10.409 | 0.035 | tINS | FF | 1 | R54C10[0][A] | store/n605_s0/COUT
10.409 | 0.000 | tNET | FF | 2 | R54C10[0][B] | store/n606_s0/CIN
10.444 | 0.035 | tINS | FF | 1 | R54C10[0][B] | store/n606_s0/COUT
10.444 | 0.000 | tNET | FF | 2 | R54C10[1][A] | store/n607_s0/CIN
10.480 | 0.035 | tINS | FF | 1 | R54C10[1][A] | store/n607_s0/COUT
10.480 | 0.000 | tNET | FF | 2 | R54C10[1][B] | store/n608_s0/CIN
10.515 | 0.035 | tINS | FF | 1 | R54C10[1][B] | store/n608_s0/COUT
10.515 | 0.000 | tNET | FF | 2 | R54C10[2][A] | store/n609_s0/CIN
10.550 | 0.035 | tINS | FF | 1 | R54C10[2][A] | store/n609_s0/COUT
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
15.654 | 0.035 | tINS | FF | 1 | R54C34[2][B] | store/n762_s0/COUT
15.654 | 0.000 | tNET | FF | 2 | R54C35[0][A] | store/n768_s0/CIN
15.689 | 0.035 | tINS | FF | 1 | R54C35[0][A] | store/n768_s0/COUT
15.689 | 0.000 | tNET | FF | 2 | R54C35[0][B] | store/n769_s0/CIN
15.724 | 0.035 | tINS | FF | 1 | R54C35[0][B] | store/n769_s0/COUT
15.724 | 0.000 | tNET | FF | 2 | R54C35[1][A] | store/n770_s0/CIN
15.760 | 0.035 | tINS | FF | 1 | R54C35[1][A] | store/n770_s0/COUT
15.760 | 0.000 | tNET | FF | 2 | R54C35[1][B] | store/n771_s0/CIN
15.795 | 0.035 | tINS | FF | 1 | R54C35[1][B] | store/n771_s0/COUT
15.795 | 0.000 | tNET | FF | 2 | R54C35[2][A] | store/n772_s0/CIN
15.830 | 0.035 | tINS | FF | 1 | R54C35[2][A] | store/n772_s0/COUT
15.830 | 0.000 | tNET | FF | 2 | R54C35[2][B] | store/n773_s0/CIN
15.865 | 0.035 | tINS | FF | 1 | R54C35[2][B] | store/n773_s0/COUT
15.865 | 0.000 | tNET | FF | 2 | R54C36[0][A] | store/n774_s0/CIN
15.900 | 0.035 | tINS | FF | 2 | R54C36[0][A] | store/n774_s0/COUT
18.220 | 2.319 | tNET | FF | 1 | R36C14[0][B] | store/last_record_time_31_s6/I1
18.682 | 0.462 | tINS | FR | 1 | R36C14[0][B] | store/last_record_time_31_s6/F
18.854 | 0.172 | tNET | RR | 1 | R36C13[3][B] | store/last_record_time_31_s4/I3
19.409 | 0.555 | tINS | RF | 11 | R36C13[3][B] | store/last_record_time_31_s4/F
19.834 | 0.425 | tNET | FF | 1 | R34C12[3][B] | store/last_record_time_31_s2/I2
20.205 | 0.371 | tINS | FF | 222 | R34C12[3][B] | store/last_record_time_31_s2/F
23.596 | 3.391 | tNET | FF | 1 | R34C5[3][A] | store/write_shift_543_s4/I1
24.049 | 0.453 | tINS | FF | 313 | R34C5[3][A] | store/write_shift_543_s4/F
26.348 | 2.299 | tNET | FF | 1 | R49C10[1][A] | store/n21594_s6/I0
26.897 | 0.549 | tINS | FR | 1 | R49C10[1][A] | store/n21594_s6/F
26.897 | 0.000 | tNET | RR | 1 | R49C10[1][A] | store/write_shift_420_s3/D

Data Required Path:

AT | DELAY | TYPE | RF | FANOUT | LOC | NODE
37.037 | 37.037 | | | | | active clock edge time
37.037 | 0.000 | | | | | sys_clk
37.037 | 0.000 | tCL | RR | 1 | IOL7[A] | clk_ibuf/I
39.125 | 2.088 | tINS | RR | 9846 | IOL7[A] | clk_ibuf/O
42.366 | 3.241 | tNET | RR | 1 | R49C10[1][A] | store/write_shift_420_s3/CLK
42.331 | -0.035 | tSu | | 1 | R49C10[1][A] | store/write_shift_420_s3

Path Statistics:

Clock Skew | 0.000
Setup Relationship | 37.037
Logic Level | 27
Arrival Clock Path Delay | cell: 2.088, 39.180%; route: 3.241, 60.820%
Arrival Data Path Delay | cell: 9.859, 45.714%; route: 11.476, 53.211%; tC2Q: 0.232, 1.076%
Required Clock Path Delay | cell: 2.088, 39.180%; route: 3.241, 60.820%

### Path7

Path Summary:

Slack | 15.435
Data Arrival Time | 26.897
Data Required Time | 42.331
From | control/event_packet_244_s0
To | store/write_shift_439_s3
Launch Clk | sys_clk:[R]
Latch Clk | sys_clk:[R]

Data Arrival Path:

AT | DELAY | TYPE | RF | FANOUT | LOC | NODE
0.000 | 0.000 | | | | | active clock edge time
0.000 | 0.000 | | | | | sys_clk
0.000 | 0.000 | tCL | RR | 1 | IOL7[A] | clk_ibuf/I
2.088 | 2.088 | tINS | RR | 9846 | IOL7[A] | clk_ibuf/O
5.329 | 3.241 | tNET | RR | 1 | R17C8[0][A] | control/event_packet_244_s0/CLK
5.561 | 0.232 | tC2Q | RF | 4 | R17C8[0][A] | control/event_packet_244_s0/Q
8.287 | 2.726 | tNET | FF | 1 | R54C5[3][A] | store/capture_packet_244_s0/I0
8.836 | 0.549 | tINS | FR | 1 | R54C5[3][A] | store/capture_packet_244_s0/F
8.980 | 0.144 | tNET | RR | 2 | R54C5[2][B] | store/n580_s0/I0
9.529 | 0.549 | tINS | RR | 1 | R54C5[2][B] | store/n580_s0/COUT
9.529 | 0.000 | tNET | RR | 2 | R54C6[0][A] | store/n581_s0/CIN
9.564 | 0.035 | tINS | RF | 1 | R54C6[0][A] | store/n581_s0/COUT
9.564 | 0.000 | tNET | FF | 2 | R54C6[0][B] | store/n582_s0/CIN
9.600 | 0.035 | tINS | FF | 1 | R54C6[0][B] | store/n582_s0/COUT
9.600 | 0.000 | tNET | FF | 2 | R54C6[1][A] | store/n583_s0/CIN
9.635 | 0.035 | tINS | FF | 1 | R54C6[1][A] | store/n583_s0/COUT
9.635 | 0.000 | tNET | FF | 2 | R54C6[1][B] | store/n584_s0/CIN
9.670 | 0.035 | tINS | FF | 1 | R54C6[1][B] | store/n584_s0/COUT
9.670 | 0.000 | tNET | FF | 2 | R54C6[2][A] | store/n585_s0/CIN
9.705 | 0.035 | tINS | FF | 1 | R54C6[2][A] | store/n585_s0/COUT
9.705 | 0.000 | tNET | FF | 2 | R54C6[2][B] | store/n586_s0/CIN
9.740 | 0.035 | tINS | FF | 1 | R54C6[2][B] | store/n586_s0/COUT
9.740 | 0.000 | tNET | FF | 2 | R54C7[0][A] | store/n587_s0/CIN
9.776 | 0.035 | tINS | FF | 1 | R54C7[0][A] | store/n587_s0/COUT
9.776 | 0.000 | tNET | FF | 2 | R54C7[0][B] | store/n588_s0/CIN
9.811 | 0.035 | tINS | FF | 1 | R54C7[0][B] | store/n588_s0/COUT
9.811 | 0.000 | tNET | FF | 2 | R54C7[1][A] | store/n589_s0/CIN
9.846 | 0.035 | tINS | FF | 1 | R54C7[1][A] | store/n589_s0/COUT
9.846 | 0.000 | tNET | FF | 2 | R54C7[1][B] | store/n590_s0/CIN
9.881 | 0.035 | tINS | FF | 1 | R54C7[1][B] | store/n590_s0/COUT
9.881 | 0.000 | tNET | FF | 2 | R54C7[2][A] | store/n591_s0/CIN
9.916 | 0.035 | tINS | FF | 1 | R54C7[2][A] | store/n591_s0/COUT
9.916 | 0.000 | tNET | FF | 2 | R54C7[2][B] | store/n592_s0/CIN
9.952 | 0.035 | tINS | FF | 1 | R54C7[2][B] | store/n592_s0/COUT
9.952 | 0.000 | tNET | FF | 2 | R54C8[0][A] | store/n593_s0/CIN
9.987 | 0.035 | tINS | FF | 1 | R54C8[0][A] | store/n593_s0/COUT
9.987 | 0.000 | tNET | FF | 2 | R54C8[0][B] | store/n594_s0/CIN
10.022 | 0.035 | tINS | FF | 1 | R54C8[0][B] | store/n594_s0/COUT
10.022 | 0.000 | tNET | FF | 2 | R54C8[1][A] | store/n595_s0/CIN
10.057 | 0.035 | tINS | FF | 1 | R54C8[1][A] | store/n595_s0/COUT
10.057 | 0.000 | tNET | FF | 2 | R54C8[1][B] | store/n596_s0/CIN
10.092 | 0.035 | tINS | FF | 1 | R54C8[1][B] | store/n596_s0/COUT
10.092 | 0.000 | tNET | FF | 2 | R54C8[2][A] | store/n597_s0/CIN
10.128 | 0.035 | tINS | FF | 1 | R54C8[2][A] | store/n597_s0/COUT
10.128 | 0.000 | tNET | FF | 2 | R54C8[2][B] | store/n598_s0/CIN
10.163 | 0.035 | tINS | FF | 1 | R54C8[2][B] | store/n598_s0/COUT
10.163 | 0.000 | tNET | FF | 2 | R54C9[0][A] | store/n599_s0/CIN
10.198 | 0.035 | tINS | FF | 1 | R54C9[0][A] | store/n599_s0/COUT
10.198 | 0.000 | tNET | FF | 2 | R54C9[0][B] | store/n600_s0/CIN
10.233 | 0.035 | tINS | FF | 1 | R54C9[0][B] | store/n600_s0/COUT
10.233 | 0.000 | tNET | FF | 2 | R54C9[1][A] | store/n601_s0/CIN
10.268 | 0.035 | tINS | FF | 1 | R54C9[1][A] | store/n601_s0/COUT
10.268 | 0.000 | tNET | FF | 2 | R54C9[1][B] | store/n602_s0/CIN
10.304 | 0.035 | tINS | FF | 1 | R54C9[1][B] | store/n602_s0/COUT
10.304 | 0.000 | tNET | FF | 2 | R54C9[2][A] | store/n603_s0/CIN
10.339 | 0.035 | tINS | FF | 1 | R54C9[2][A] | store/n603_s0/COUT
10.339 | 0.000 | tNET | FF | 2 | R54C9[2][B] | store/n604_s0/CIN
10.374 | 0.035 | tINS | FF | 1 | R54C9[2][B] | store/n604_s0/COUT
10.374 | 0.000 | tNET | FF | 2 | R54C10[0][A] | store/n605_s0/CIN
10.409 | 0.035 | tINS | FF | 1 | R54C10[0][A] | store/n605_s0/COUT
10.409 | 0.000 | tNET | FF | 2 | R54C10[0][B] | store/n606_s0/CIN
10.444 | 0.035 | tINS | FF | 1 | R54C10[0][B] | store/n606_s0/COUT
10.444 | 0.000 | tNET | FF | 2 | R54C10[1][A] | store/n607_s0/CIN
10.480 | 0.035 | tINS | FF | 1 | R54C10[1][A] | store/n607_s0/COUT
10.480 | 0.000 | tNET | FF | 2 | R54C10[1][B] | store/n608_s0/CIN
10.515 | 0.035 | tINS | FF | 1 | R54C10[1][B] | store/n608_s0/COUT
10.515 | 0.000 | tNET | FF | 2 | R54C10[2][A] | store/n609_s0/CIN
10.550 | 0.035 | tINS | FF | 1 | R54C10[2][A] | store/n609_s0/COUT
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
15.654 | 0.035 | tINS | FF | 1 | R54C34[2][B] | store/n762_s0/COUT
15.654 | 0.000 | tNET | FF | 2 | R54C35[0][A] | store/n768_s0/CIN
15.689 | 0.035 | tINS | FF | 1 | R54C35[0][A] | store/n768_s0/COUT
15.689 | 0.000 | tNET | FF | 2 | R54C35[0][B] | store/n769_s0/CIN
15.724 | 0.035 | tINS | FF | 1 | R54C35[0][B] | store/n769_s0/COUT
15.724 | 0.000 | tNET | FF | 2 | R54C35[1][A] | store/n770_s0/CIN
15.760 | 0.035 | tINS | FF | 1 | R54C35[1][A] | store/n770_s0/COUT
15.760 | 0.000 | tNET | FF | 2 | R54C35[1][B] | store/n771_s0/CIN
15.795 | 0.035 | tINS | FF | 1 | R54C35[1][B] | store/n771_s0/COUT
15.795 | 0.000 | tNET | FF | 2 | R54C35[2][A] | store/n772_s0/CIN
15.830 | 0.035 | tINS | FF | 1 | R54C35[2][A] | store/n772_s0/COUT
15.830 | 0.000 | tNET | FF | 2 | R54C35[2][B] | store/n773_s0/CIN
15.865 | 0.035 | tINS | FF | 1 | R54C35[2][B] | store/n773_s0/COUT
15.865 | 0.000 | tNET | FF | 2 | R54C36[0][A] | store/n774_s0/CIN
15.900 | 0.035 | tINS | FF | 2 | R54C36[0][A] | store/n774_s0/COUT
18.220 | 2.319 | tNET | FF | 1 | R36C14[0][B] | store/last_record_time_31_s6/I1
18.682 | 0.462 | tINS | FR | 1 | R36C14[0][B] | store/last_record_time_31_s6/F
18.854 | 0.172 | tNET | RR | 1 | R36C13[3][B] | store/last_record_time_31_s4/I3
19.409 | 0.555 | tINS | RF | 11 | R36C13[3][B] | store/last_record_time_31_s4/F
19.834 | 0.425 | tNET | FF | 1 | R34C12[3][B] | store/last_record_time_31_s2/I2
20.205 | 0.371 | tINS | FF | 222 | R34C12[3][B] | store/last_record_time_31_s2/F
23.596 | 3.391 | tNET | FF | 1 | R34C5[3][A] | store/write_shift_543_s4/I1
24.049 | 0.453 | tINS | FF | 313 | R34C5[3][A] | store/write_shift_543_s4/F
26.348 | 2.299 | tNET | FF | 1 | R41C9[0][A] | store/n21575_s6/I0
26.897 | 0.549 | tINS | FR | 1 | R41C9[0][A] | store/n21575_s6/F
26.897 | 0.000 | tNET | RR | 1 | R41C9[0][A] | store/write_shift_439_s3/D

Data Required Path:

AT | DELAY | TYPE | RF | FANOUT | LOC | NODE
37.037 | 37.037 | | | | | active clock edge time
37.037 | 0.000 | | | | | sys_clk
37.037 | 0.000 | tCL | RR | 1 | IOL7[A] | clk_ibuf/I
39.125 | 2.088 | tINS | RR | 9846 | IOL7[A] | clk_ibuf/O
42.366 | 3.241 | tNET | RR | 1 | R41C9[0][A] | store/write_shift_439_s3/CLK
42.331 | -0.035 | tSu | | 1 | R41C9[0][A] | store/write_shift_439_s3

Path Statistics:

Clock Skew | 0.000
Setup Relationship | 37.037
Logic Level | 27
Arrival Clock Path Delay | cell: 2.088, 39.180%; route: 3.241, 60.820%
Arrival Data Path Delay | cell: 9.859, 45.714%; route: 11.476, 53.211%; tC2Q: 0.232, 1.076%
Required Clock Path Delay | cell: 2.088, 39.180%; route: 3.241, 60.820%
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
