liangzhi0754/three-fpga-musical-instrument/validation/diagnostics_preview.png

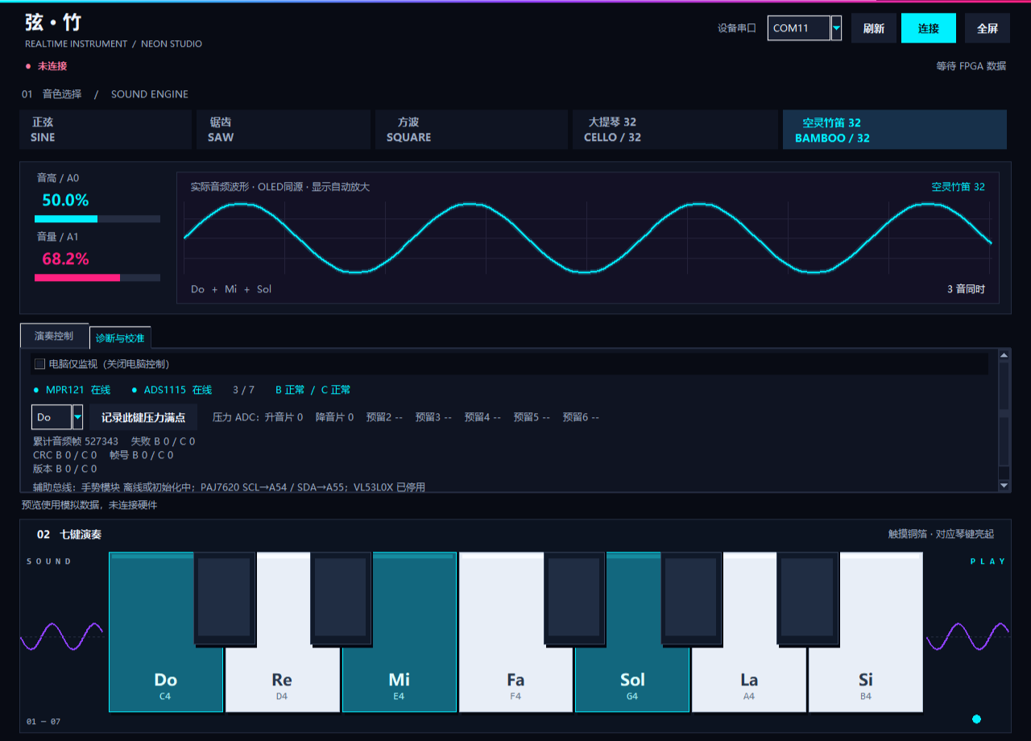
validation/diagnostics_preview.png
