liangzhi0754/three-fpga-musical-instrument/src/common/node_control_cdc.v

// Compatibility note: packet RX now runs wholly in the local clk domain.
// Cross-domain control sampling is intentionally handled inside ctrl_packet_rx.
// This file has no active module and is not included in the project.
