liangzhi0754/three-fpga-musical-instrument/src/board_a/aux_program.v

// Sensor register script. PAJ table: Seeed Studio MIT, see reference/paj7620.h.
// VL53L0X sequence: Pololu/ST, see reference/LICENSE-VL53L0X.txt.
// Fixed default ranging configuration; no cover-glass compensation is assumed.
module aux_program(input wire [8:0] pc,output reg [48:0] instruction);
 always @* case(pc)
  9'd0: instruction={4'd7,1'b0,8'h00,8'h00,8'h00,4'd0,16'd30};
  9'd1: instruction={4'd5,1'b0,8'hc0,8'hee,8'hff,4'd0,16'd0};
  9'd2: instruction={4'd3,1'b0,8'h89,8'h01,8'hff,4'd0,16'd0};
  9'd3: instruction={4'd0,1'b0,8'h88,8'h00,8'h00,4'd0,16'd0};
  9'd4: instruction={4'd0,1'b0,8'h80,8'h01,8'h00,4'd0,16'd0};
  9'd5: instruction={4'd0,1'b0,8'hff,8'h01,8'h00,4'd0,16'd0};
  9'd6: instruction={4'd0,1'b0,8'h00,8'h00,8'h00,4'd0,16'd0};
  9'd7: instruction={4'd1,1'b0,8'h91,8'h00,8'h00,4'd0,16'd0};
  9'd8: instruction={4'd0,1'b0,8'h00,8'h01,8'h00,4'd0,16'd0};
  9'd9: instruction={4'd0,1'b0,8'hff,8'h00,8'h00,4'd0,16'd0};
  9'd10: instruction={4'd0,1'b0,8'h80,8'h00,8'h00,4'd0,16'd0};
  9'd11: instruction={4'd3,1'b0,8'h60,8'h12,8'hff,4'd0,16'd0};
  9'd12: instruction={4'd0,1'b0,8'h44,8'h00,8'h00,4'd0,16'd0};
  9'd13: instruction={4'd0,1'b0,8'h45,8'h20,8'h00,4'd0,16'd0};
  9'd14: instruction={4'd0,1'b0,8'h01,8'hff,8'h00,4'd0,16'd0};
  9'd15: instruction={4'd0,1'b0,8'h80,8'h01,8'h00,4'd0,16'd0};
  9'd16: instruction={4'd0,1'b0,8'hff,8'h01,8'h00,4'd0,16'd0};
  9'd17: instruction={4'd0,1'b0,8'h00,8'h00,8'h00,4'd0,16'd0};
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
  9'd244: instruction={4'd5,1'b1,8'h41,8'hff,8'hff,4'd0,16'd0};
  9'd245: instruction={4'd7,1'b1,8'h00,8'h00,8'h00,4'd0,16'd20};
  9'd246: instruction={4'd9,1'b1,8'h00,8'h00,8'h00,4'd0,16'd214};
  default:instruction={4'd9,1'b0,8'd0,8'd0,8'd0,4'd0,16'd218};
 endcase
endmodule
