liangzhi0754/three-fpga-musical-instrument/src/board_c/oled_trig_lut.v

// One-period Q9 trigonometric coefficients; not recorded audio.
module oled_trig_lut(input wire [7:0] phase,
 output reg signed [9:0] cos_value,output reg signed [9:0] sin_value);
 always @* begin
  case(phase)
   8'd0:begin cos_value=10'sd511;sin_value=10'sd0;end
   8'd1:begin cos_value=10'sd511;sin_value=10'sd13;end
   8'd2:begin cos_value=10'sd510;sin_value=10'sd25;end
   8'd3:begin cos_value=10'sd510;sin_value=10'sd38;end
   8'd4:begin cos_value=10'sd509;sin_value=10'sd50;end
   8'd5:begin cos_value=10'sd507;sin_value=10'sd63;end
   8'd6:begin cos_value=10'sd505;sin_value=10'sd75;end
   8'd7:begin cos_value=10'sd503;sin_value=10'sd87;end
   8'd8:begin cos_value=10'sd501;sin_value=10'sd100;end
   8'd9:begin cos_value=10'sd499;sin_value=10'sd112;end
   8'd10:begin cos_value=10'sd496;sin_value=10'sd124;end
   8'd11:begin cos_value=10'sd492;sin_value=10'sd136;end
   8'd12:begin cos_value=10'sd489;sin_value=10'sd148;end
   8'd13:begin cos_value=10'sd485;sin_value=10'sd160;end
   8'd14:begin cos_value=10'sd481;sin_value=10'sd172;end
   8'd15:begin cos_value=10'sd477;sin_value=10'sd184;end
   8'd16:begin cos_value=10'sd472;sin_value=10'sd196;end
   8'd17:begin cos_value=10'sd467;sin_value=10'sd207;end
   8'd18:begin cos_value=10'sd462;sin_value=10'sd218;end
   8'd19:begin cos_value=10'sd456;sin_value=10'sd230;end
   8'd20:begin cos_value=10'sd451;sin_value=10'sd241;end
   8'd21:begin cos_value=10'sd445;sin_value=10'sd252;end
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
   8'd246:begin cos_value=10'sd496;sin_value=-10'sd124;end
   8'd247:begin cos_value=10'sd499;sin_value=-10'sd112;end
   8'd248:begin cos_value=10'sd501;sin_value=-10'sd100;end
   8'd249:begin cos_value=10'sd503;sin_value=-10'sd87;end
   8'd250:begin cos_value=10'sd505;sin_value=-10'sd75;end
   8'd251:begin cos_value=10'sd507;sin_value=-10'sd63;end
   8'd252:begin cos_value=10'sd509;sin_value=-10'sd50;end
   8'd253:begin cos_value=10'sd510;sin_value=-10'sd38;end
   8'd254:begin cos_value=10'sd510;sin_value=-10'sd25;end
   8'd255:begin cos_value=10'sd511;sin_value=-10'sd13;end
   default:begin cos_value=0;sin_value=0;end
  endcase
 end
endmodule
